Ingenierie-Systeme/united-team-repo/Slides RDV/RDV5.pdf

# United Team

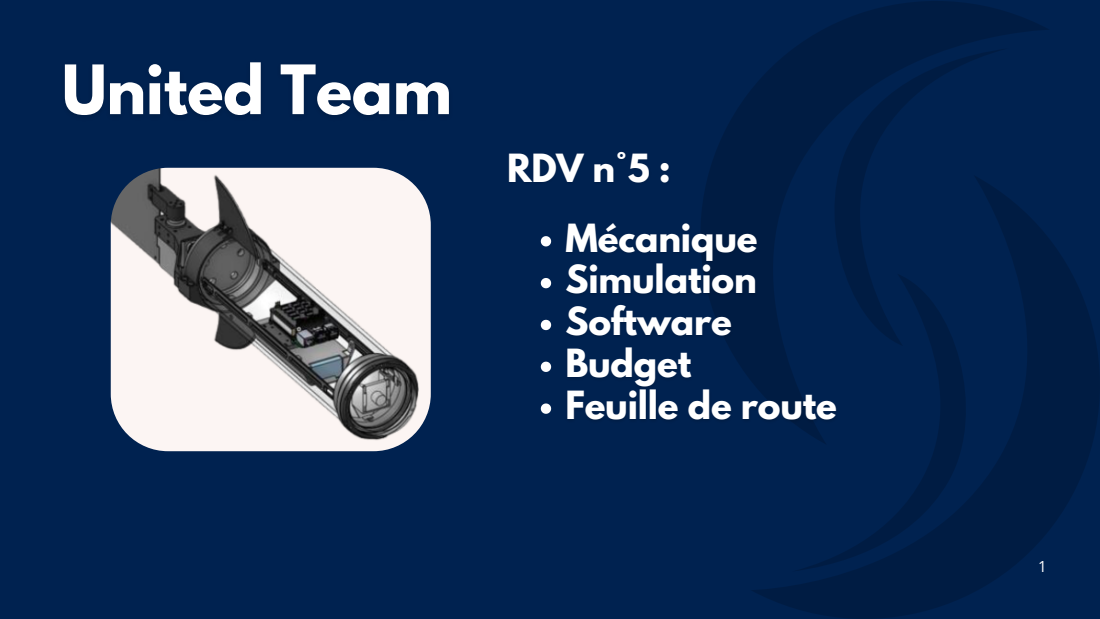
[picture p4: page 1]
RDV n; Mécanique Simulation Software Budget Feuille de route

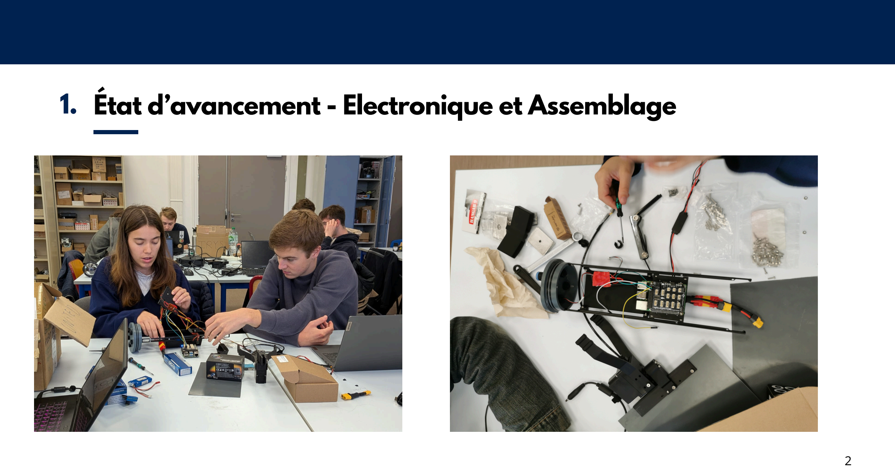
[picture p5: page 2]

### 1. État d’avancement - Electronique et Assemblage

2

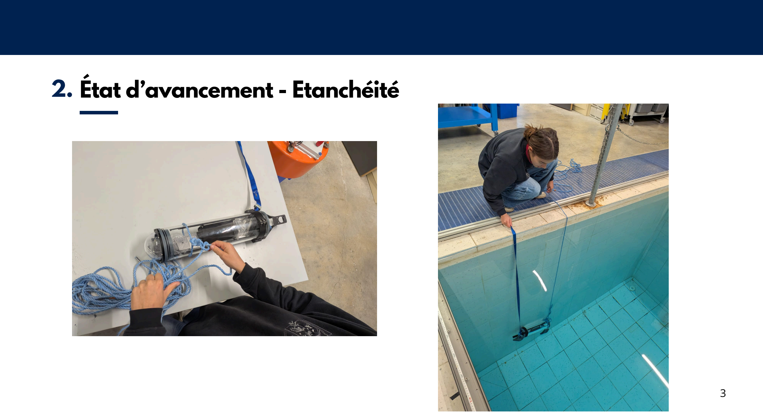
[picture p6: page 3]

### 2. État d’avancement - Etanchéité

3

### 3. État d’avancement - Simulation 3D

4

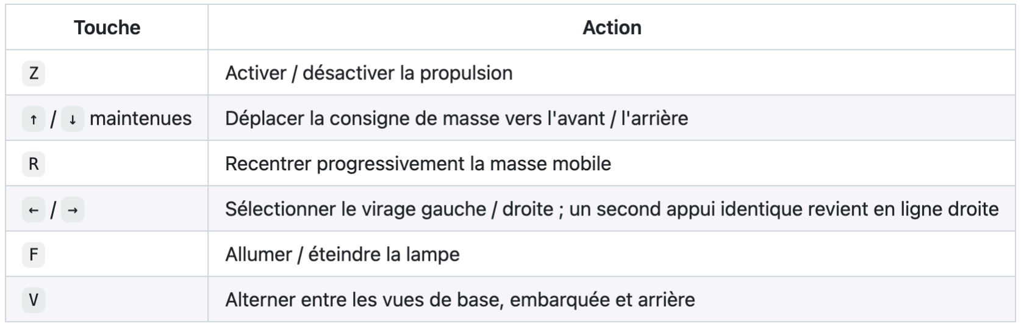
[picture p7: figure]

### 4. État d’avancement - Budget

5

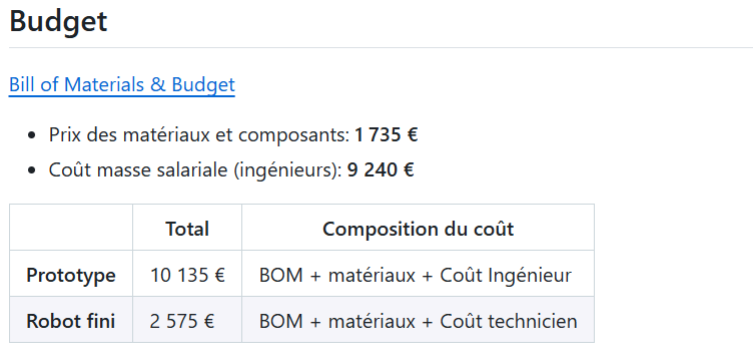
[picture p8: figure]

### 4. État d’avancement - Tests de l’électronique

6

Test servo-moteurs
Test caméra

Test lampe

### 4. État d’avancement - Contrôle et software

7

Fait

En cours

Contrôle manuel clavier pour avancer et tourner

Régulation autonome en
altitude
Stratégie différente pour la rotation

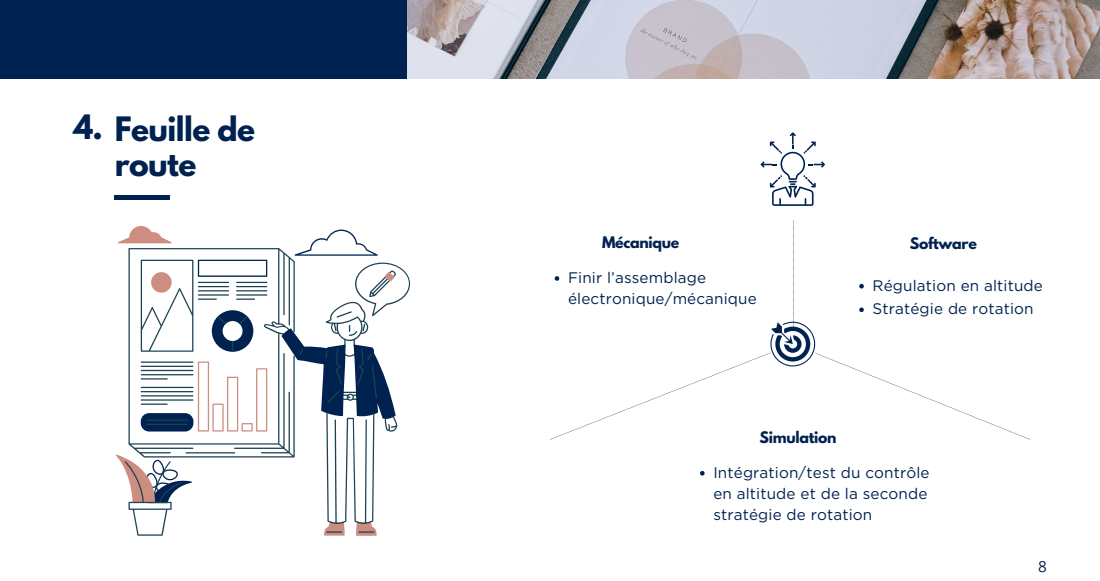
[picture p9: page 8]
4. Feuille de route; Finir l’assemblage électronique/mécanique; Mécanique; Software

Régulation en altitude
Stratégie de rotation

Simulation
Intégration/test du contrôle
en altitude et de la seconde
stratégie de rotation

9

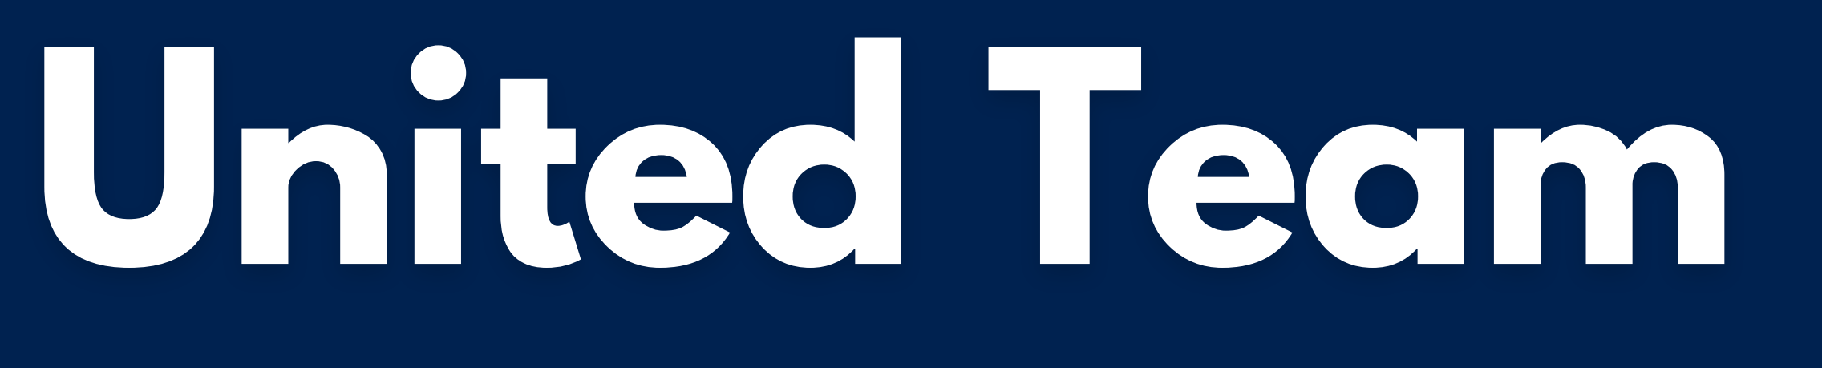
[picture p10: figure]
United Team
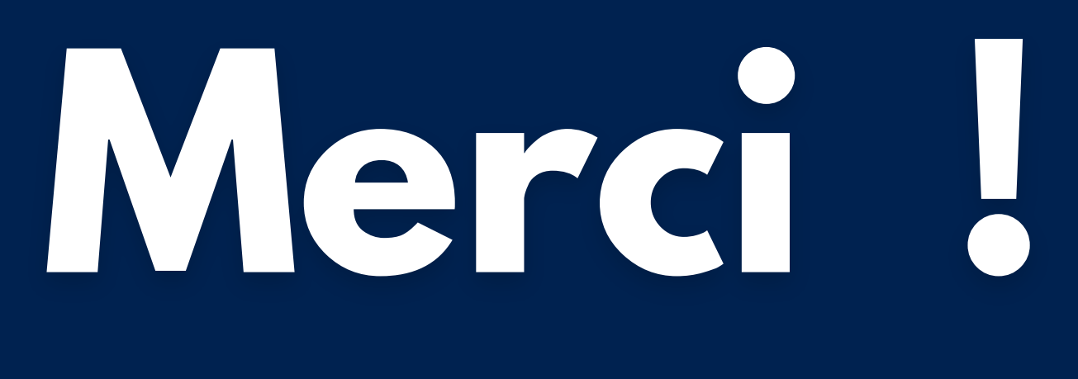
[picture p11: figure]
Merci !
