Ingenierie-Systeme/united-team-repo/Slides RDV/RDV4.pdf

# United Team

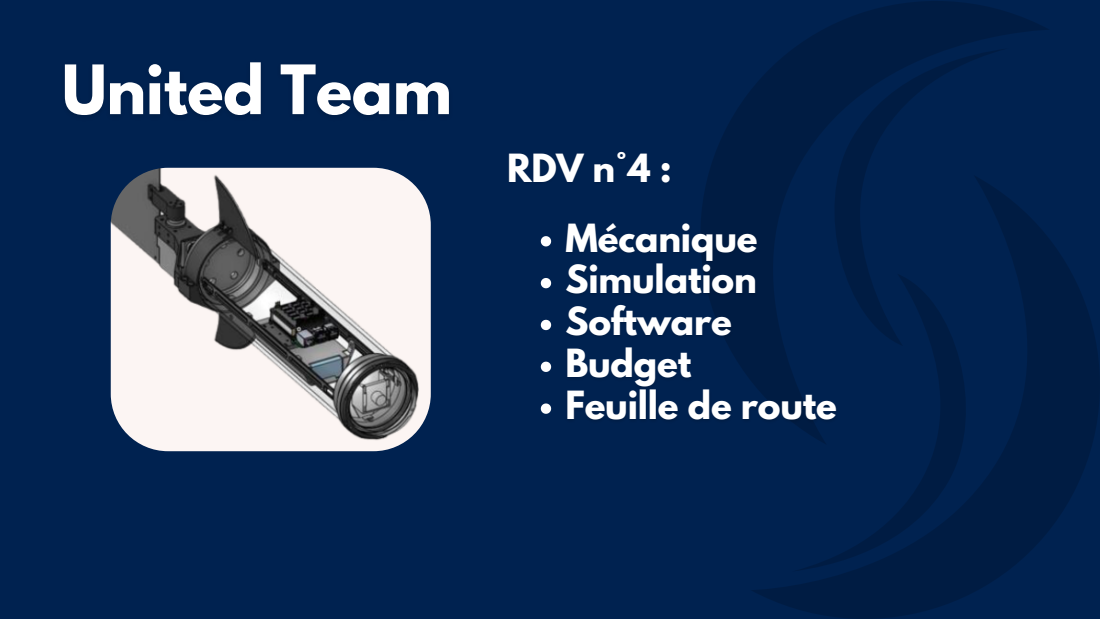
[picture p12: page 1]
RDV n; Mécanique Simulation Software Budget Feuille de route

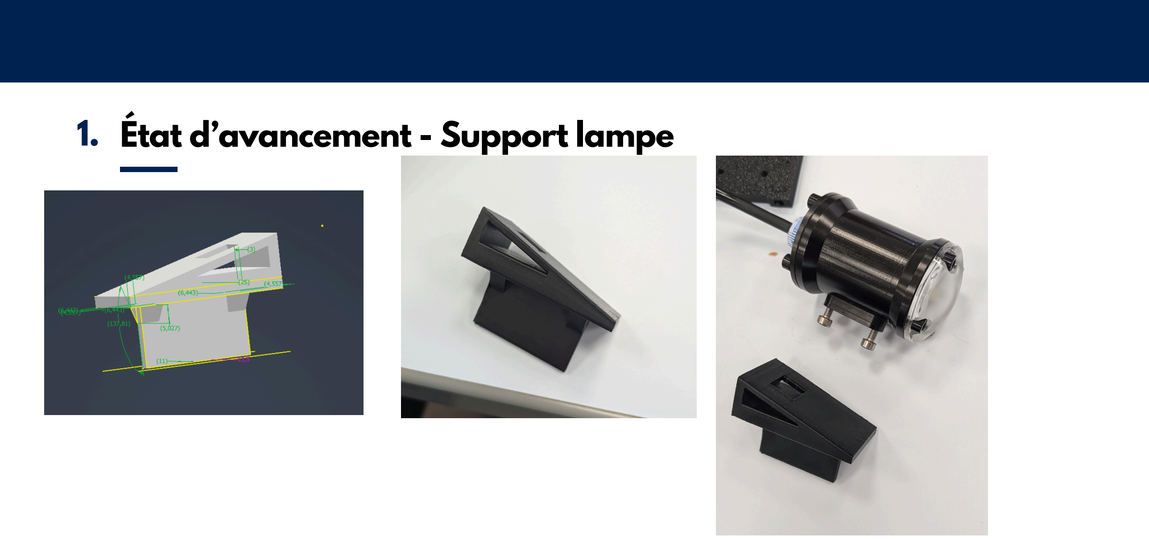
[picture p13: page 2]

### 1. État d’avancement - Support lampe

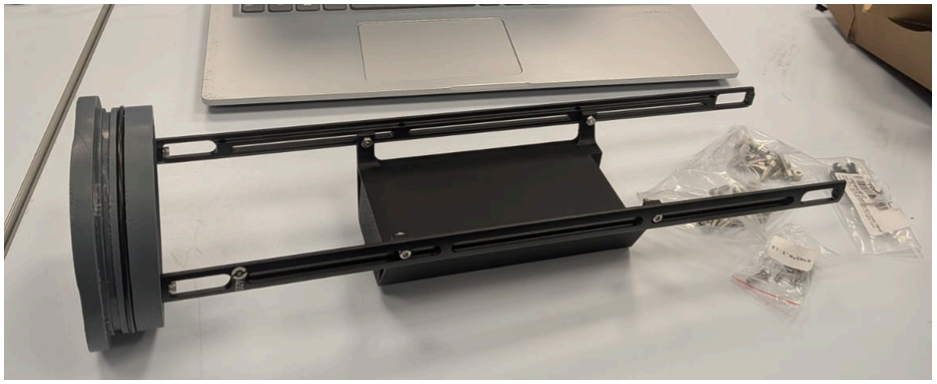
[picture p14: figure]
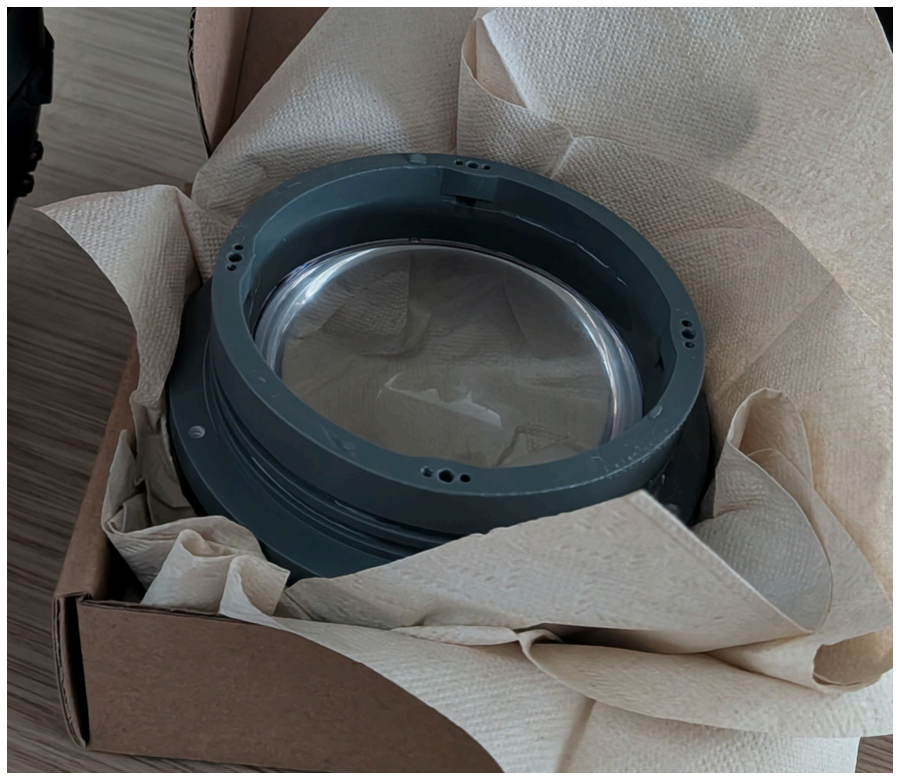
[picture p15: figure]

### 1. État d’avancement - Tube

Taraudage et test d’étanchéité

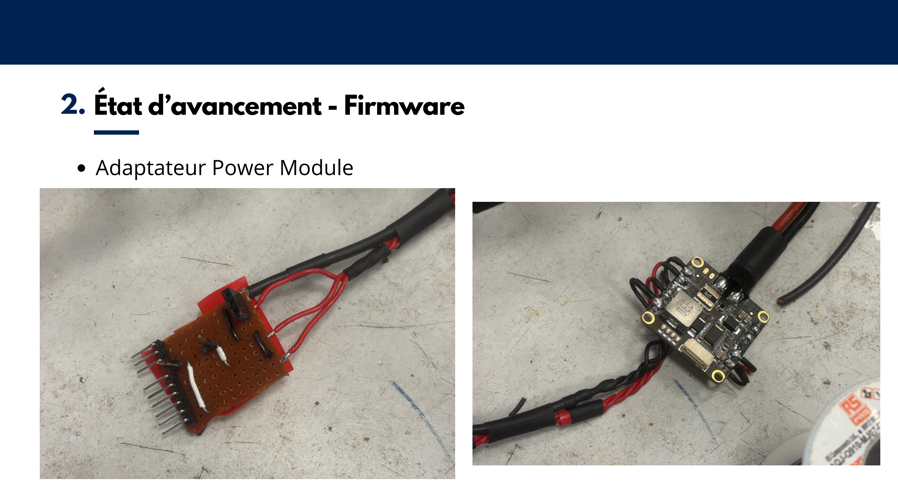
[picture p16: page 4]

### 2. État d’avancement - Firmware

Adaptateur Power Module

### 3. État d’avancement - Simulation

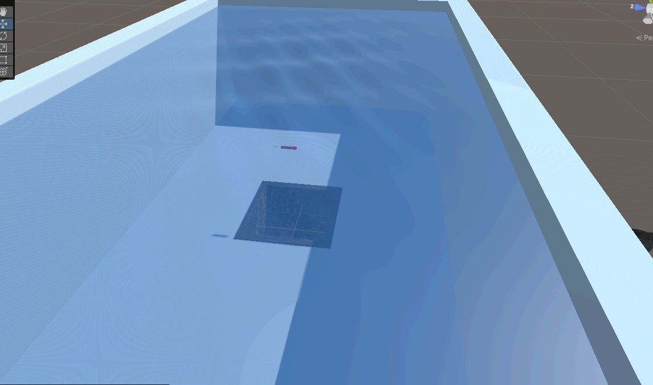
[picture p17: figure]

### 3. État d’avancement - Simulation

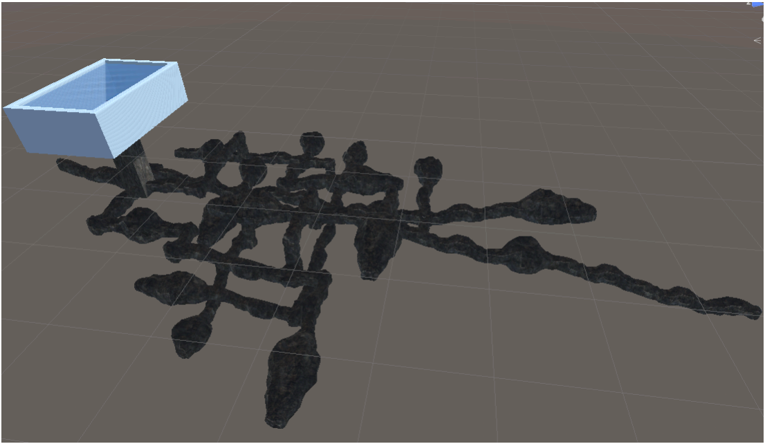
[picture p18: figure]

### 3. État d’avancement - Simulation


### 3. État d’avancement - Software

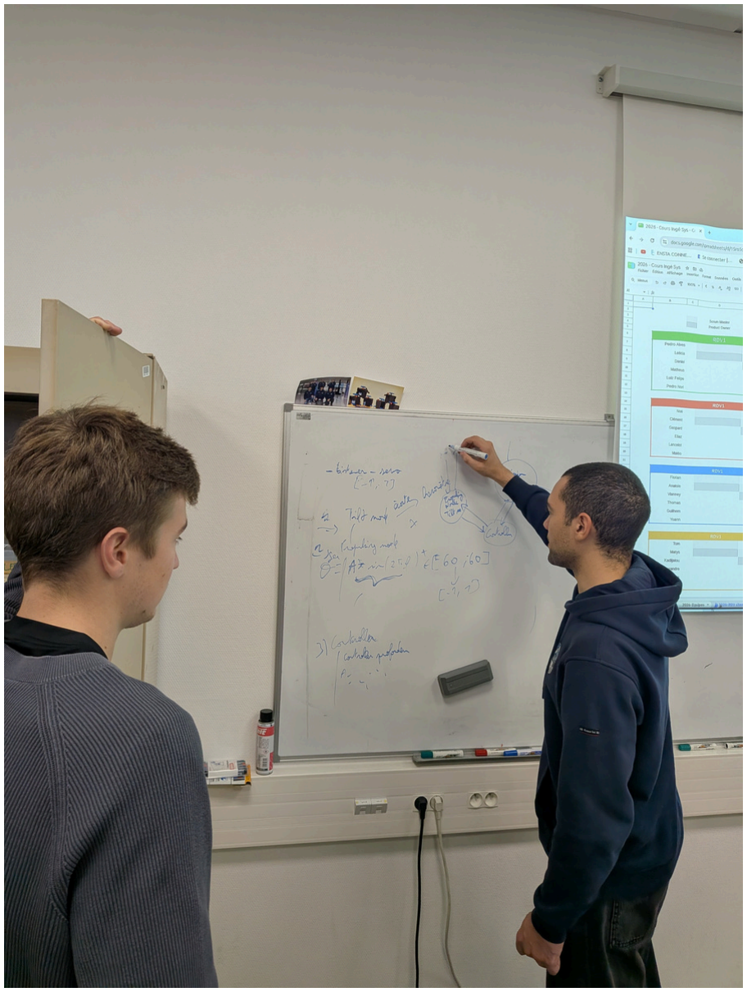
[picture p19: figure]

Fait :
Tester ROS2 avec IMU, lampe, pas encore servo

En cours :
mise en place d’un régulateur en cap et profondeur

### 4. État d’avancement - Budget sur README.md

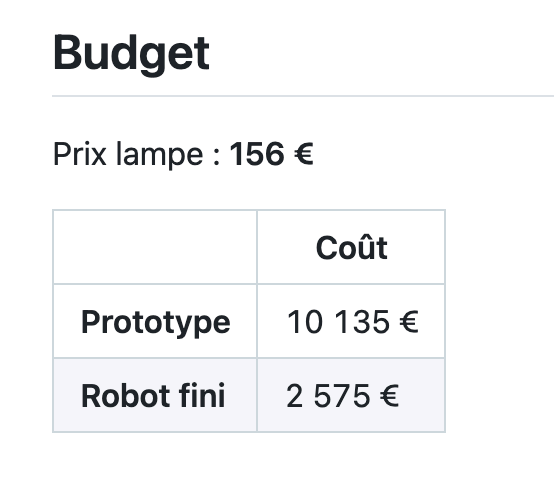
[picture p20: figure]
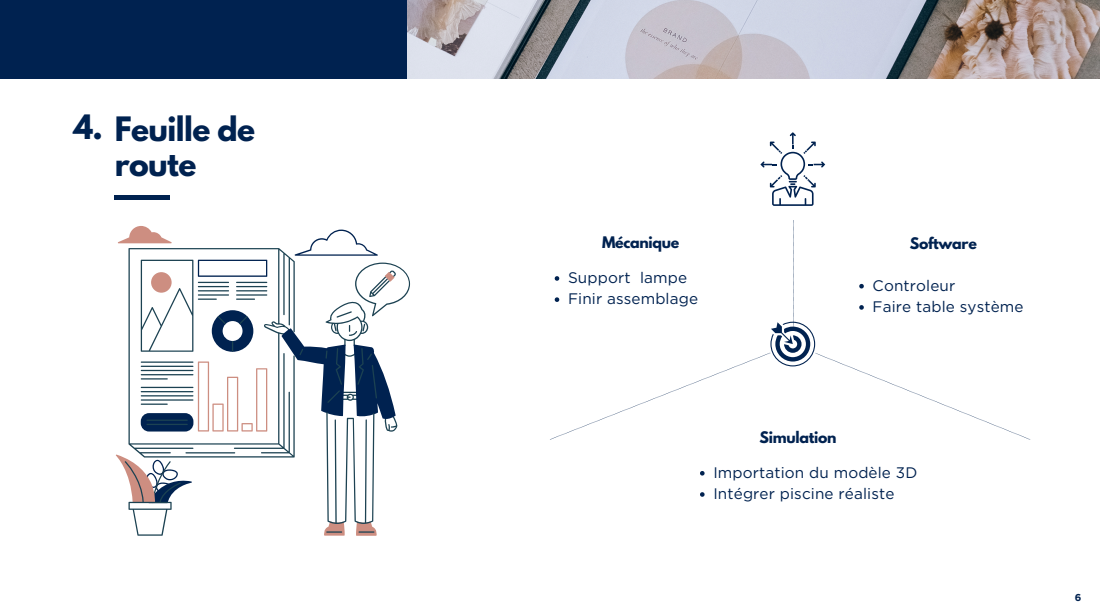
[picture p21: page 10]
4. Feuille de route; Support lampe Finir assemblage; Mécanique; Software

Controleur
Faire table système

Simulation
Importation du modèle 3D
Intégrer piscine réaliste

United Team
Merci !
