Ingenierie-Systeme/united-team-repo/Slides RDV/RDV3.pdf

# United Team

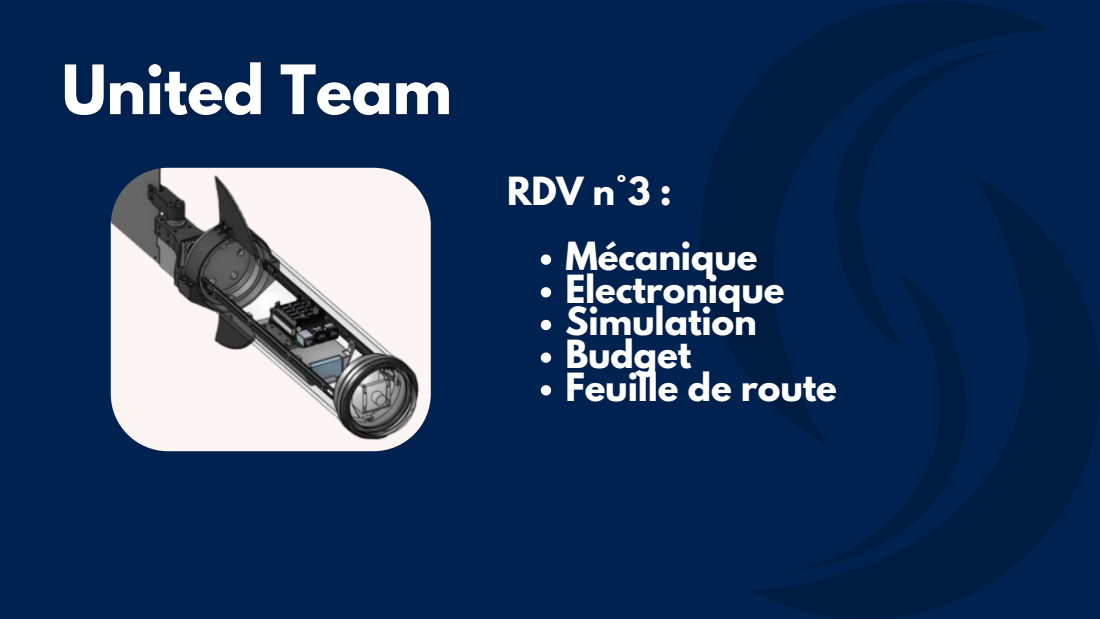
[picture p22: page 1]
RDV n; Mécanique Electronique Simulation Budget Feuille de route

# Montage du moteur étanche 1. État d’avancement - Mécanique

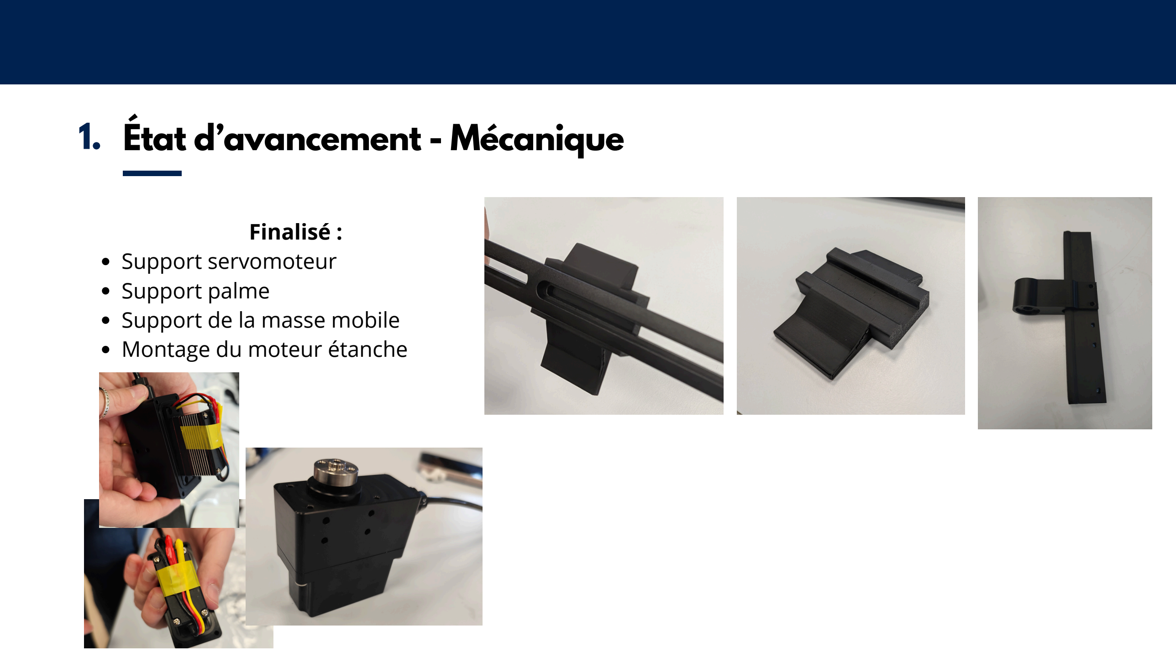
[picture p23: page 2]

# Finalisé :

# Support servomoteur Support palme Support de la masse mobile

# 1. État d’avancement - Mécanique

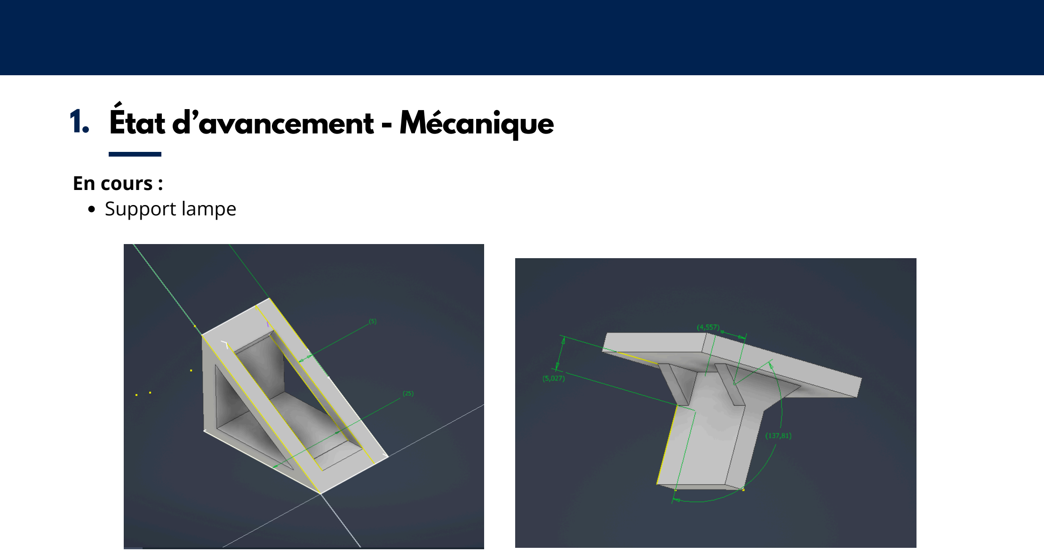
[picture p24: page 3]

# Support lampe

# En cours :

# 2. État d’avancement - Electronique

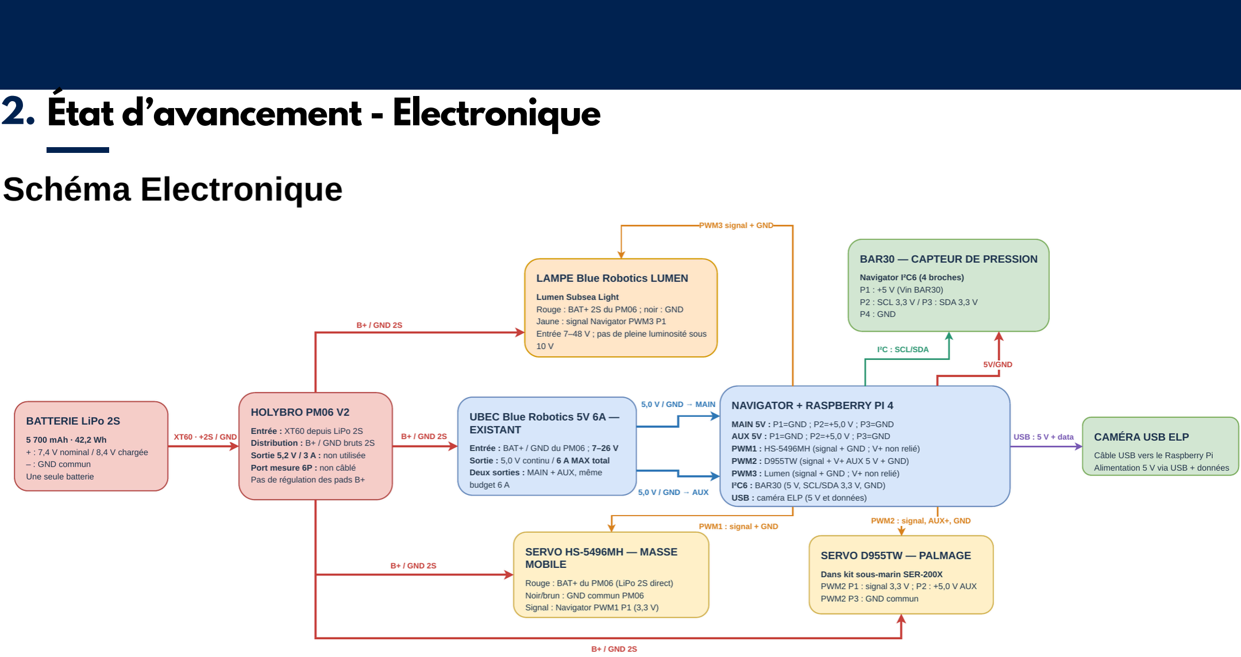
[picture p25: page 4]

# 2. État d’avancement - Firmware

# Setup RaspberryPi packages ROS 2 / packages Python

# 2. État d’avancement - Simulation

# Connexion avec ROS2 Ajout de l’IMU / Capteur de pression

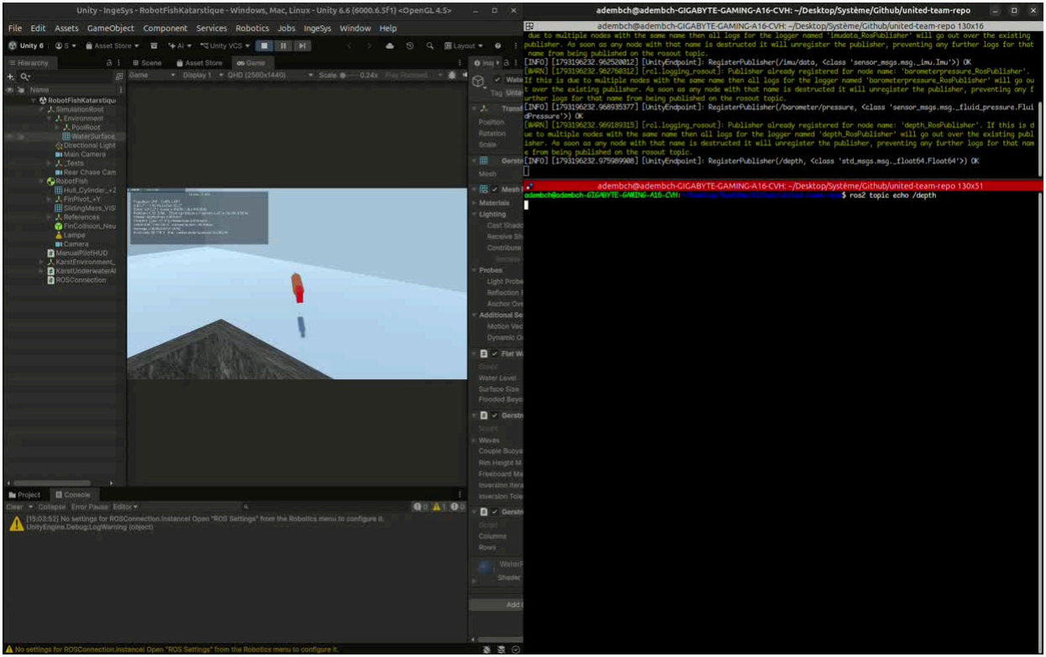
[picture p26: figure]

# 2. État d’avancement - Simulation

# Ajout d’une scène karstique et de la lampe

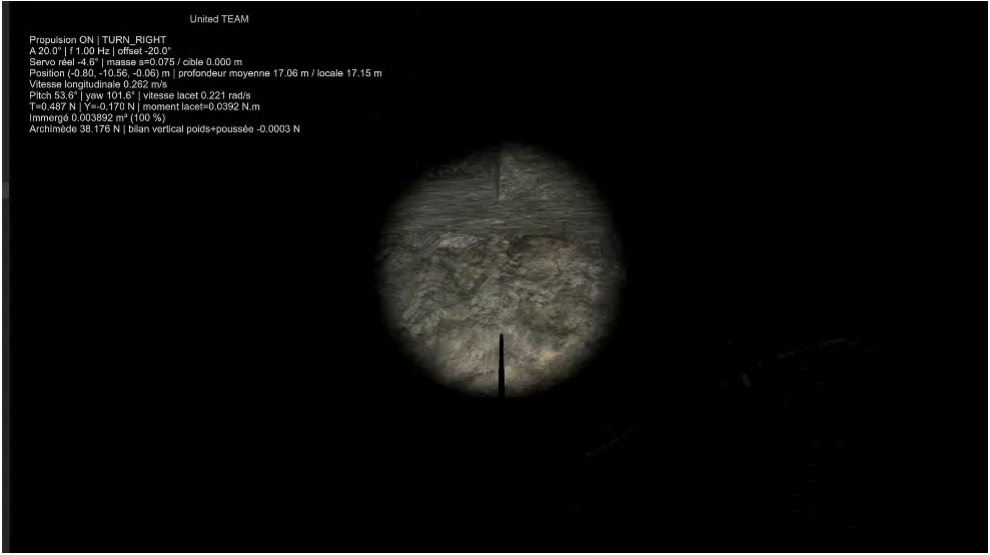
[picture p27: figure]

# 2. État d’avancement - Simulation

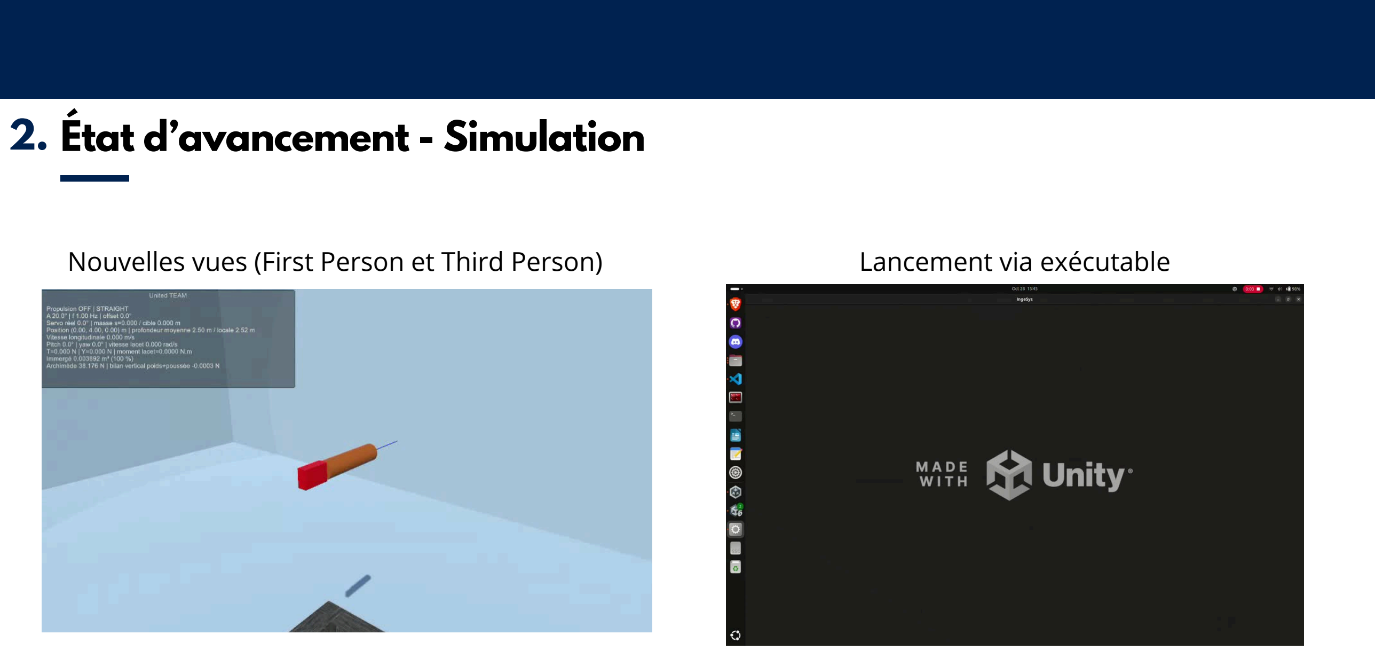
[picture p28: page 8]

Nouvelles vues (First Person et Third Person) | Lancement via exécutable

# 2. État d’avancement - Budget

# Nouveau prix avec la lampe :

10 135 €

+156 €

# Coût prototype : Coût robot fini :

2 575 €

# 4. Feuille de route

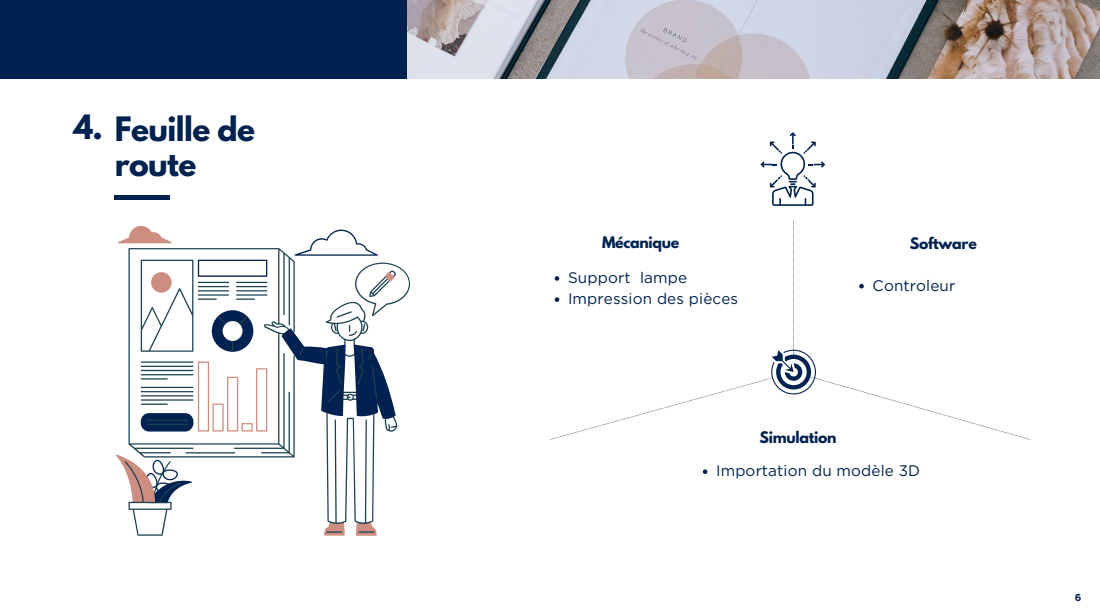
[picture p29: page 10]
Controleur; Software

Mécanique
Support lampe
Impression des pièces

Simulation
Importation du modèle 3D

United Team
Merci !

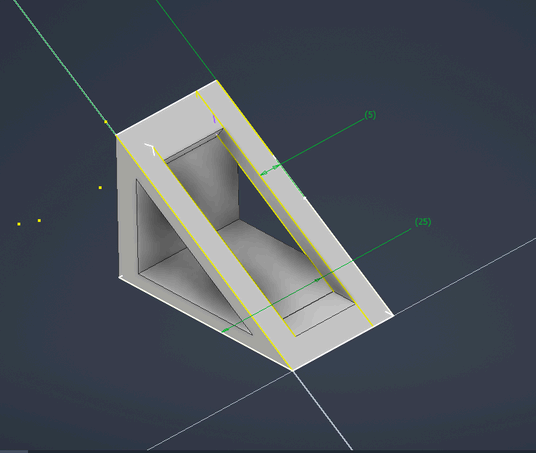
[picture p30: figure]
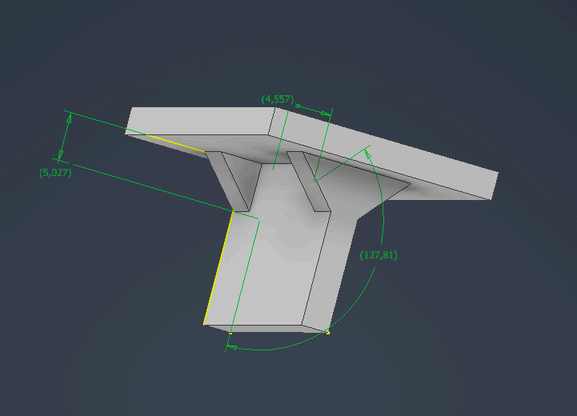
[picture p31: figure]

# 2. État d’avancement - CAO

# Finalisé :

# Support servomoteur masse mobile Support palme Support de la masse mobile

# En cours :

# Support lampe

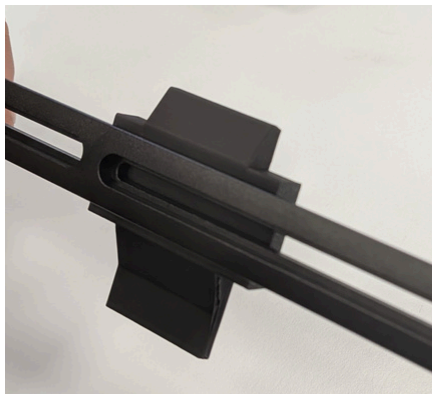
[picture p32: figure]
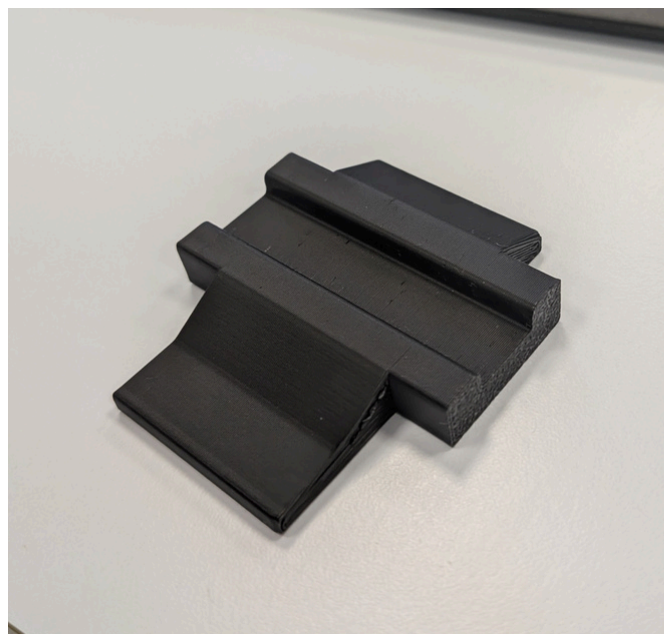
[picture p33: figure]
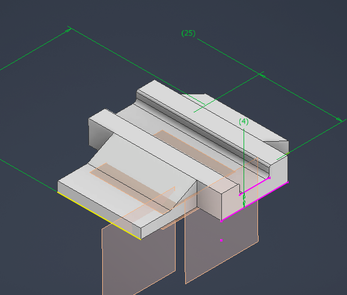
[picture p34: figure]

# 2. État d’avancement - Simulateur & Firmware

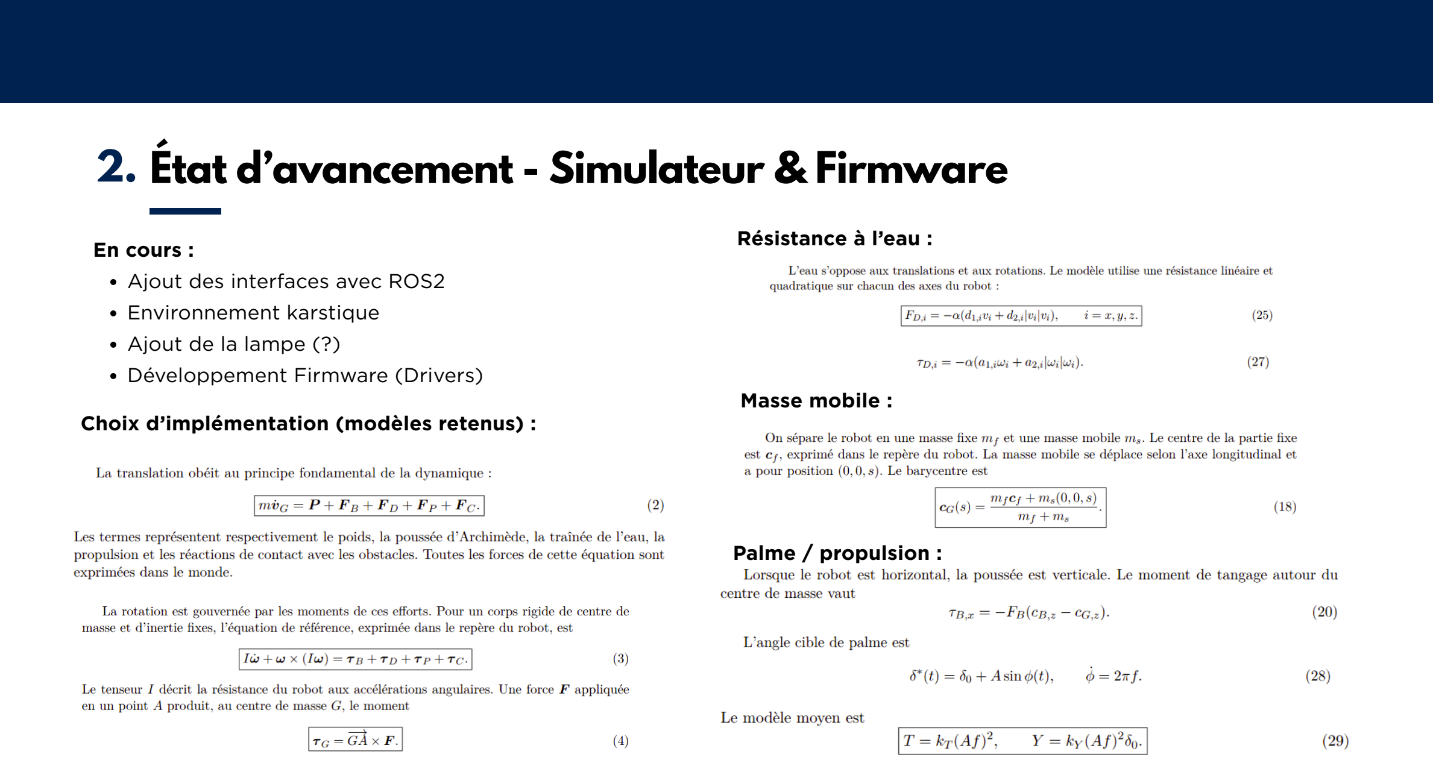
[picture p35: page 13]

# En cours : Ajout des interfaces avec ROS2 Environnement karstique Ajout de la lampe (?) Développement Firmware (Drivers)

# Choix d’implémentation (modèles retenus) :

# Résistance à l’eau :

# Masse mobile :

# Palme / propulsion :

# 2. État d’avancement - Simulateur & Firmware

# Modèle de Houle Trochoïdale (Gerstner) :

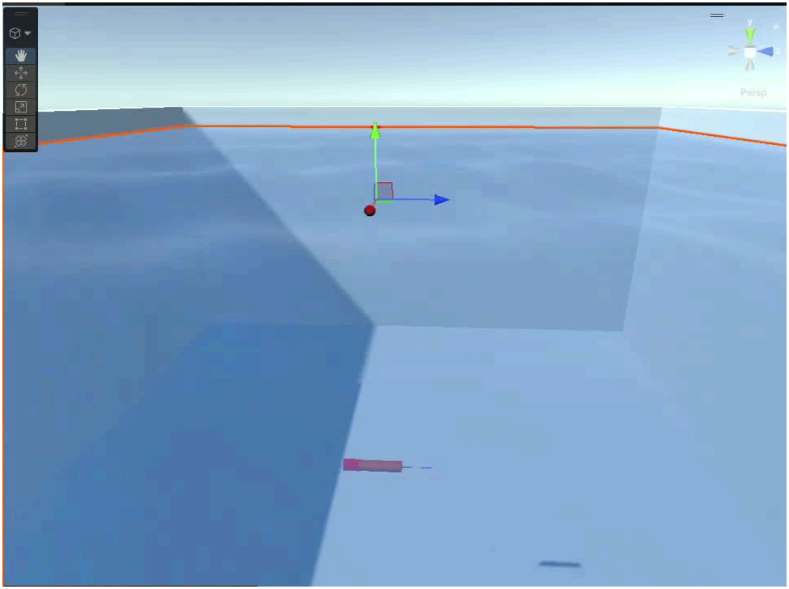
[picture p36: figure]

# Présentation du

1.

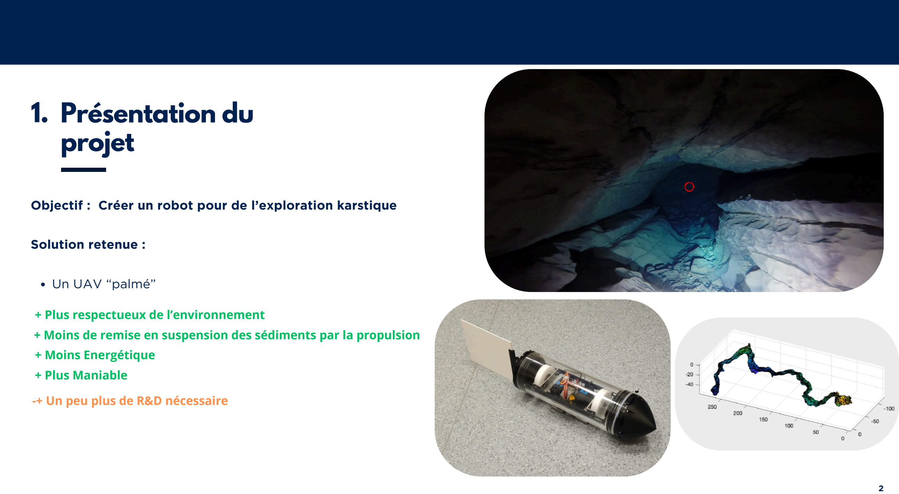
[picture p37: page 15]

# Objectif : Créer un robot pour de l’exploration karstique

# Solution retenue :

# Un UAV “palmé”

# projet

2

# + Plus respectueux de l’environnement

# + Moins Energétique

# -+ Un peu plus de R&D nécessaire

# + Moins de remise en suspension des sédiments par la propulsion

# + Plus Maniable

# 3. Etat d’avancement

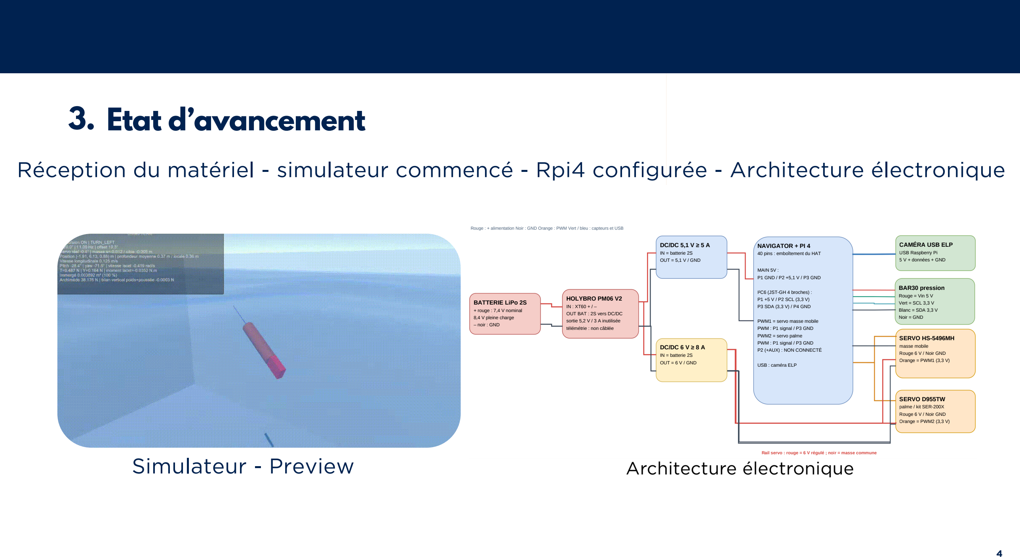
[picture p38: page 16]

4

# Réception du matériel - simulateur commencé - Rpi4 configurée - Architecture électronique

# Simulateur - Preview

Rouge : + alimentation Noir : GND Orange : PWM Vert / bleu : capteurs et USB

Rail servo : rouge = 6 V régulé ; noir = masse commune

### BATTERIE LiPo 2S

+ rouge : 7,4 V nominal
8,4 V pleine charge
– noir : GND

### HOLYBRO PM06 V2

IN : XT60 + / –
OUT BAT : 2S vers DC/DC
sortie 5,2 V / 3 A inutilisée télémétrie : non câblée

### DC/DC 6 V ≥ 8 A

IN = batterie 2S
OUT = 6 V / GND

### DC/DC 5,1 V ≥ 5 A

IN = batterie 2S
OUT = 5,1 V / GND

### NAVIGATOR + PI 4

40 pins : emboîtement du HAT

### SERVO D955TW

palme / kit SER-200X
Rouge 6 V / Noir GND
Orange = PWM2 (3,3 V)

### BAR30 pression

Rouge = Vin 5 V
Vert = SCL 3,3 V
Blanc = SDA 3,3 V
Noir = GND

### CAMÉRA USB ELP

USB Raspberry Pi
5 V + données + GND

### SERVO HS-5496MH

masse mobile
Rouge 6 V / Noir GND
Orange = PWM1 (3,3 V)
USB : caméra ELP

I²C6 (JST-GH 4 broches) :
P1 +5 V / P2 SCL (3,3 V)
P3 SDA (3,3 V) / P4 GND

MAIN 5V :
P1 GND / P2 +5,1 V / P3 GND

PWM1 = servo masse mobile
PWM : P1 signal / P3 GND
PWM2 = servo palme
PWM : P1 signal / P3 GND
P2 (+AUX) : NON CONNECTÉ

# Architecture électronique

# Rouge : + alimentation Noir : GND Orange : PWM Vert / bleu : capteurs et USB

# DC/DC 5,1 V ≥ 5 A

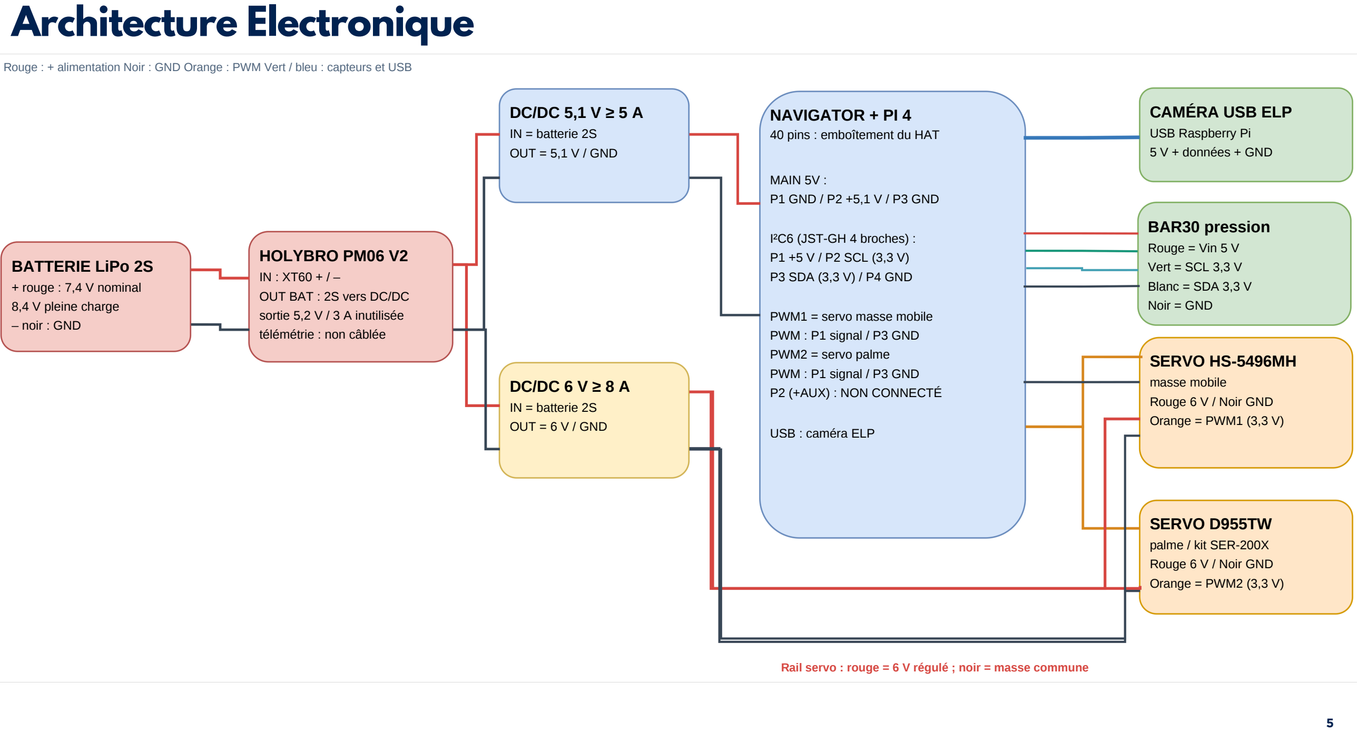
[picture p39: page 17]

# Rail servo : rouge = 6 V régulé ; noir = masse commune

# BATTERIE LiPo 2S

# + rouge : 7,4 V nominal 8,4 V pleine charge – noir : GND

# HOLYBRO PM06 V2

# IN : XT60 + / – OUT BAT : 2S vers DC/DC sortie 5,2 V / 3 A inutilisée télémétrie : non câblée

# DC/DC 6 V ≥ 8 A

# IN = batterie 2S OUT = 6 V / GND

# IN = batterie 2S OUT = 5,1 V / GND

# NAVIGATOR + PI 4

# 40 pins : emboîtement du HAT

# SERVO D955TW

# palme / kit SER-200X Rouge 6 V / Noir GND Orange = PWM2 (3,3 V)

# BAR30 pression

# Rouge = Vin 5 V Vert = SCL 3,3 V Blanc = SDA 3,3 V Noir = GND

# CAMÉRA USB ELP

# USB Raspberry Pi 5 V + données + GND

# SERVO HS-5496MH

# masse mobile Rouge 6 V / Noir GND Orange = PWM1 (3,3 V) USB : caméra ELP

# I²C6 (JST-GH 4 broches) : P1 +5 V / P2 SCL (3,3 V) P3 SDA (3,3 V) / P4 GND

# MAIN 5V : P1 GND / P2 +5,1 V / P3 GND

# PWM1 = servo masse mobile PWM : P1 signal / P3 GND PWM2 = servo palme PWM : P1 signal / P3 GND P2 (+AUX) : NON CONNECTÉ

# Architecture Electronique

5
