Ingenierie-Systeme/united-team-repo/Slides RDV/RDV1.pdf

# United Team

# RDV n

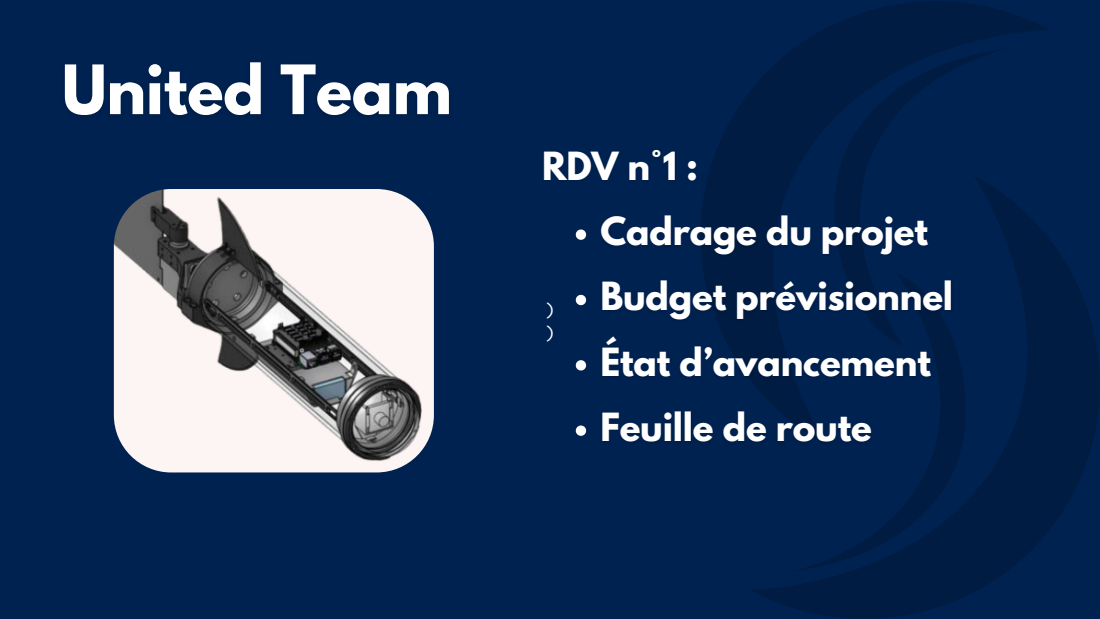
[picture p40: page 1]
Cadrage du projet; Budget prévisionnel État d’avancement; Feuille de route

RDV n
Cadrage du projet
Budget prévisionnel
État d’avancement
Feuille de route

# Présentation du

1.


# Objectif : Créer un robot pour de l’exploration karstique

# Solution retenue :

# Un UAV “palmé”

# projet

2

# + Plus respectueux de l’environnement

# + Moins Energétique

# -+ Un peu plus de R&D nécessaire

# + Moins de remise en suspension des sédiments par la propulsion

# + Plus Maniable

# Budget Prévisionnel

2.

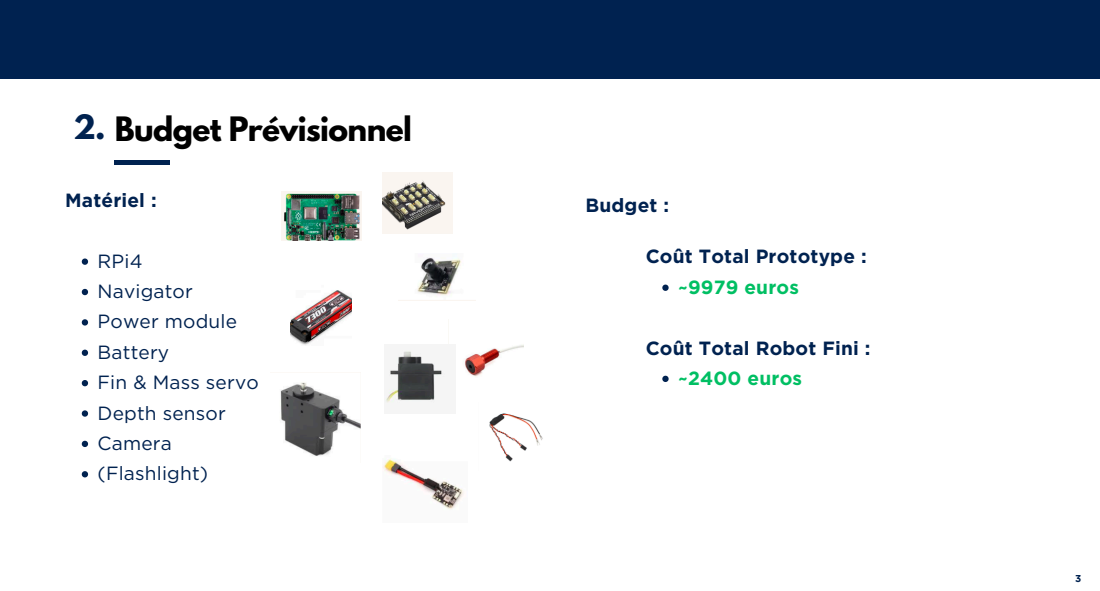
[picture p41: page 3]
Matériel :; RPi4 Navigator Power module Battery Fin & Mass servo Depth sensor Camera (Flashlight); Budget :

Coût Total Prototype :
~9979 euros

Coût Total Robot Fini :
~2400 euros

# 3. Etat d’avancement


4

# Réception du matériel - simulateur commencé - Rpi4 configurée - Architecture électronique

# Simulateur - Preview

Rouge : + alimentation Noir : GND Orange : PWM Vert / bleu : capteurs et USB

Rail servo : rouge = 6 V régulé ; noir = masse commune

### BATTERIE LiPo 2S

+ rouge : 7,4 V nominal
8,4 V pleine charge
– noir : GND

### HOLYBRO PM06 V2

IN : XT60 + / –
OUT BAT : 2S vers DC/DC
sortie 5,2 V / 3 A inutilisée télémétrie : non câblée

### DC/DC 6 V ≥ 8 A

IN = batterie 2S
OUT = 6 V / GND

### DC/DC 5,1 V ≥ 5 A

IN = batterie 2S
OUT = 5,1 V / GND

### NAVIGATOR + PI 4

40 pins : emboîtement du HAT

### SERVO D955TW

palme / kit SER-200X
Rouge 6 V / Noir GND
Orange = PWM2 (3,3 V)

### BAR30 pression

Rouge = Vin 5 V
Vert = SCL 3,3 V
Blanc = SDA 3,3 V
Noir = GND

### CAMÉRA USB ELP

USB Raspberry Pi
5 V + données + GND

### SERVO HS-5496MH

masse mobile
Rouge 6 V / Noir GND
Orange = PWM1 (3,3 V)
USB : caméra ELP

I²C6 (JST-GH 4 broches) :
P1 +5 V / P2 SCL (3,3 V)
P3 SDA (3,3 V) / P4 GND

MAIN 5V :
P1 GND / P2 +5,1 V / P3 GND

PWM1 = servo masse mobile
PWM : P1 signal / P3 GND
PWM2 = servo palme
PWM : P1 signal / P3 GND
P2 (+AUX) : NON CONNECTÉ

# Architecture électronique

# Rouge : + alimentation Noir : GND Orange : PWM Vert / bleu : capteurs et USB

# DC/DC 5,1 V ≥ 5 A


# Rail servo : rouge = 6 V régulé ; noir = masse commune

# BATTERIE LiPo 2S

# + rouge : 7,4 V nominal 8,4 V pleine charge – noir : GND

# HOLYBRO PM06 V2

# IN : XT60 + / – OUT BAT : 2S vers DC/DC sortie 5,2 V / 3 A inutilisée télémétrie : non câblée

# DC/DC 6 V ≥ 8 A

# IN = batterie 2S OUT = 6 V / GND

# IN = batterie 2S OUT = 5,1 V / GND

# NAVIGATOR + PI 4

# 40 pins : emboîtement du HAT

# SERVO D955TW

# palme / kit SER-200X Rouge 6 V / Noir GND Orange = PWM2 (3,3 V)

# BAR30 pression

# Rouge = Vin 5 V Vert = SCL 3,3 V Blanc = SDA 3,3 V Noir = GND

# CAMÉRA USB ELP

# USB Raspberry Pi 5 V + données + GND

# SERVO HS-5496MH

# masse mobile Rouge 6 V / Noir GND Orange = PWM1 (3,3 V) USB : caméra ELP

# I²C6 (JST-GH 4 broches) : P1 +5 V / P2 SCL (3,3 V) P3 SDA (3,3 V) / P4 GND

# MAIN 5V : P1 GND / P2 +5,1 V / P3 GND

# PWM1 = servo masse mobile PWM : P1 signal / P3 GND PWM2 = servo palme PWM : P1 signal / P3 GND P2 (+AUX) : NON CONNECTÉ

# Architecture Electronique

5

# 4. Feuille de route

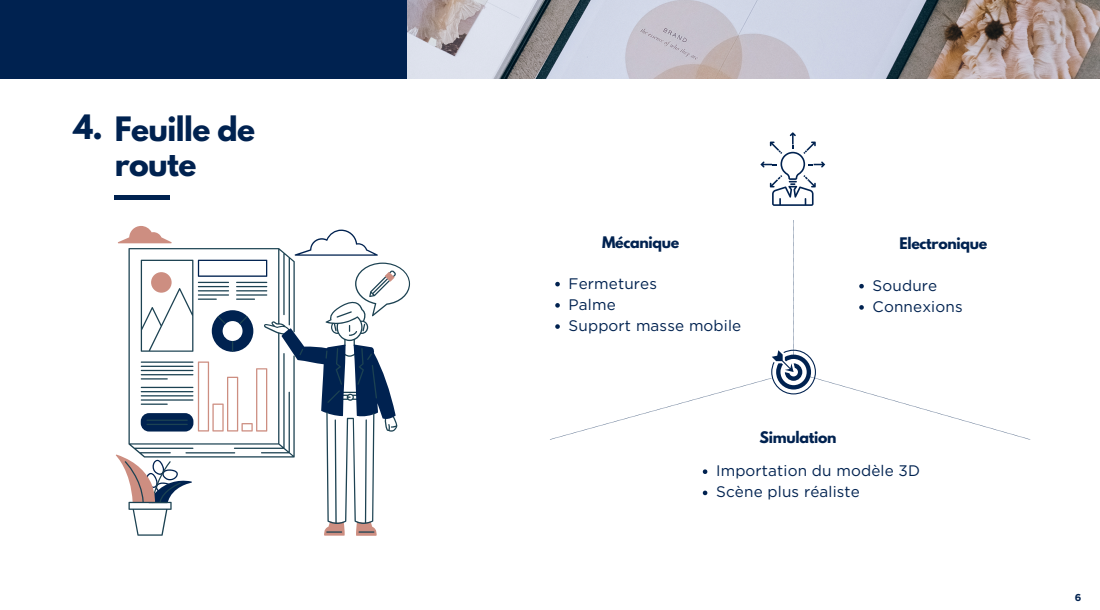
[picture p42: page 6]
Soudure Connexions; Mécanique; Electronique

Fermetures
Palme
Support masse mobile

Simulation
Importation du modèle 3D
Scène plus réaliste

United Team
Merci !
