Ingenierie-Systeme/united-team-repo/Slides RDV/RDV2.pdf

# United Team

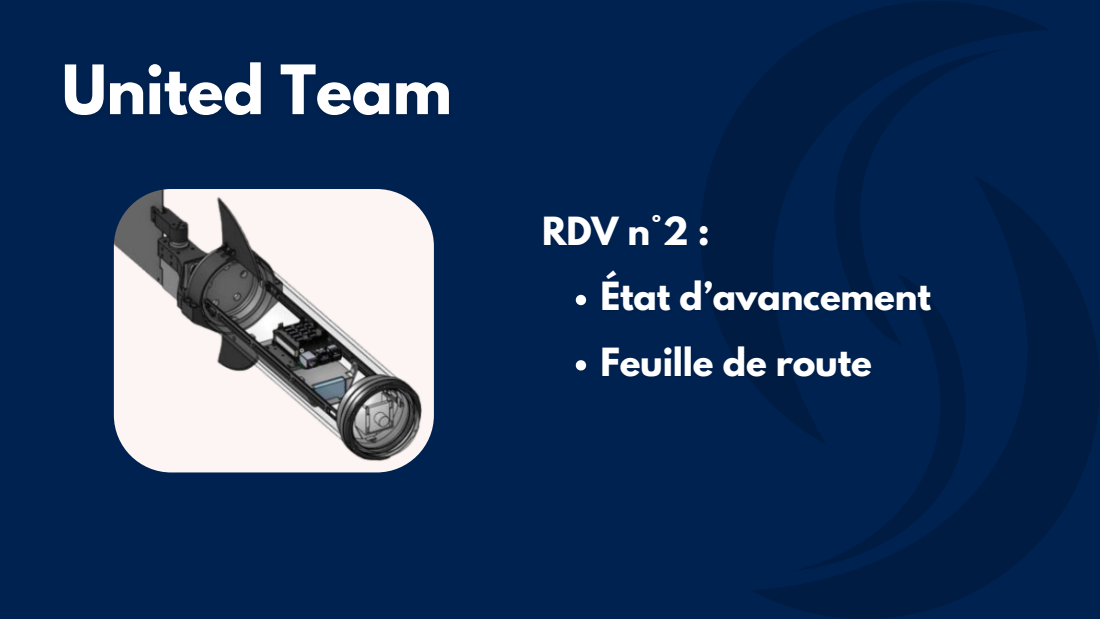
[picture p43: page 1]
RDV n

RDV n
État d’avancement
Feuille de route

# 2. État d’avancement - CAO

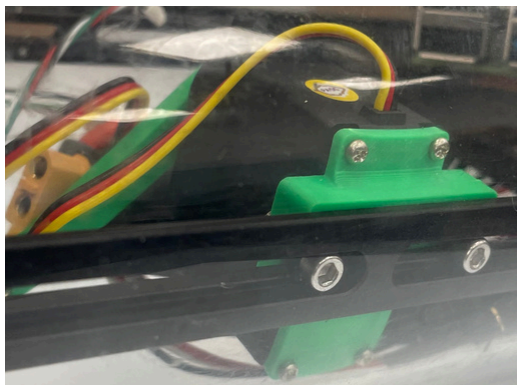
[picture p44: figure]
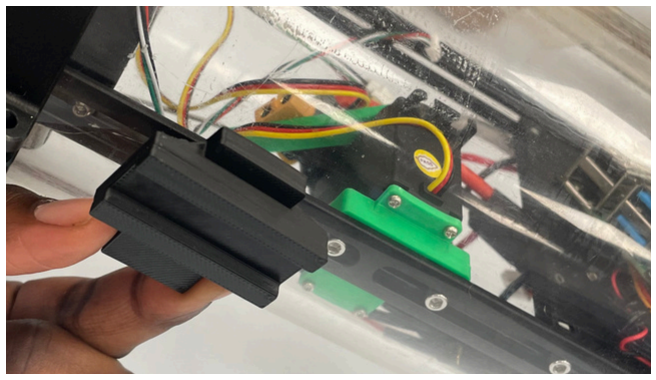
[picture p45: figure]

## En Cours :

## Support servomoteur Support palme Support de la masse mobile Complétion de la structure du robot

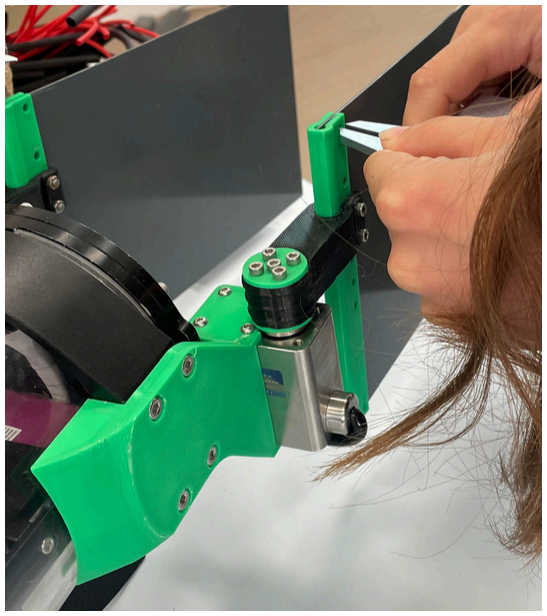
[picture p46: figure]

# 2. État d’avancement - Simulateur & Firmware


En cours :
Ajout des interfaces avec ROS2 Environnement karstique
Ajout de la lampe (?)
Développement Firmware (Drivers)

Choix d’implémentation (modèles retenus) :

Résistance à l’eau :

Masse mobile :

Palme / propulsion :

# 2. État d’avancement - Simulateur & Firmware

Modèle de Houle Trochoïdale (Gerstner) :


# 4. Feuille de route

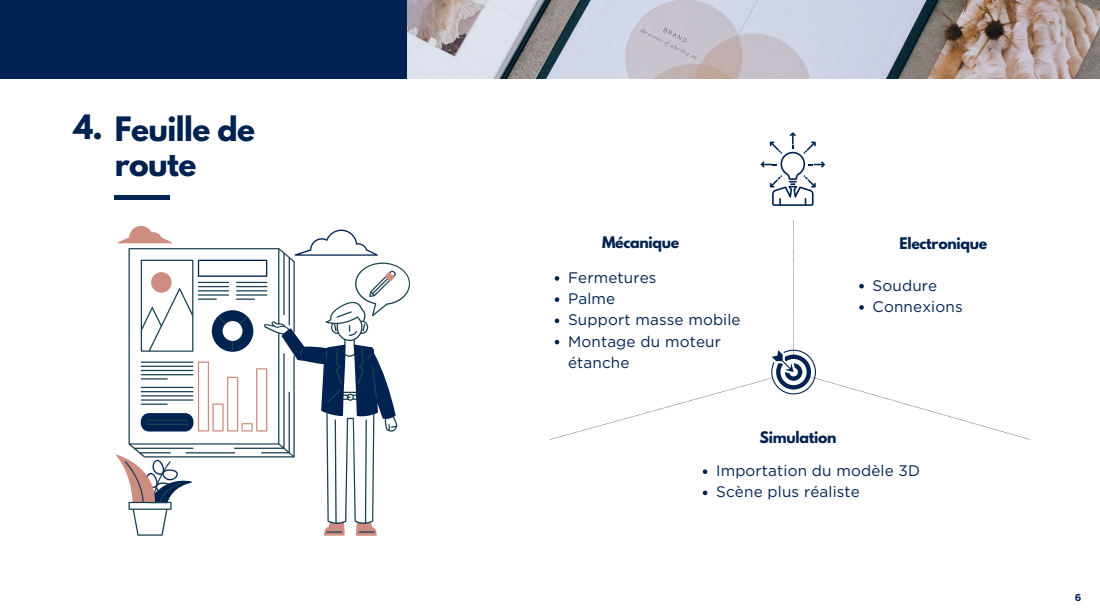
[picture p47: page 5]
Soudure Connexions; Electronique

Mécanique
Fermetures
Palme
Support masse mobile
Montage du moteur
étanche

Simulation
Importation du modèle 3D
Scène plus réaliste

United Team
Merci !
