Ingenierie-Systeme/united-team-repo/Simulateur Unity/IngeSys/IngeSys/Assets/CAD/BestPiscine/Derived/asphalt_04_MetallicSmoothness.png

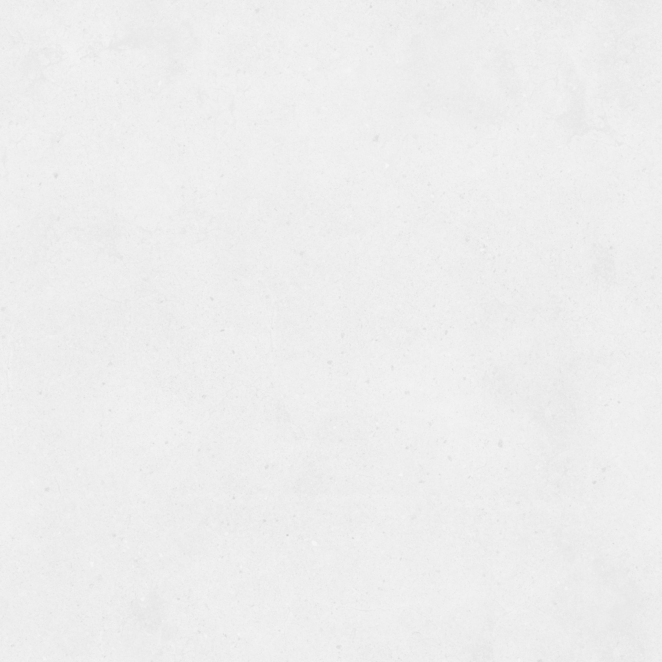
Simulateur Unity/IngeSys/IngeSys/Assets/CAD/BestPiscine/Derived/asphalt_04_MetallicSmoothness.png
