Ingenierie-Systeme/united-team-repo/Simulateur Unity/IngeSys/IngeSys/Assets/CAD/BestPiscine/Derived/beige_wall_001_MetallicSmoothness.png

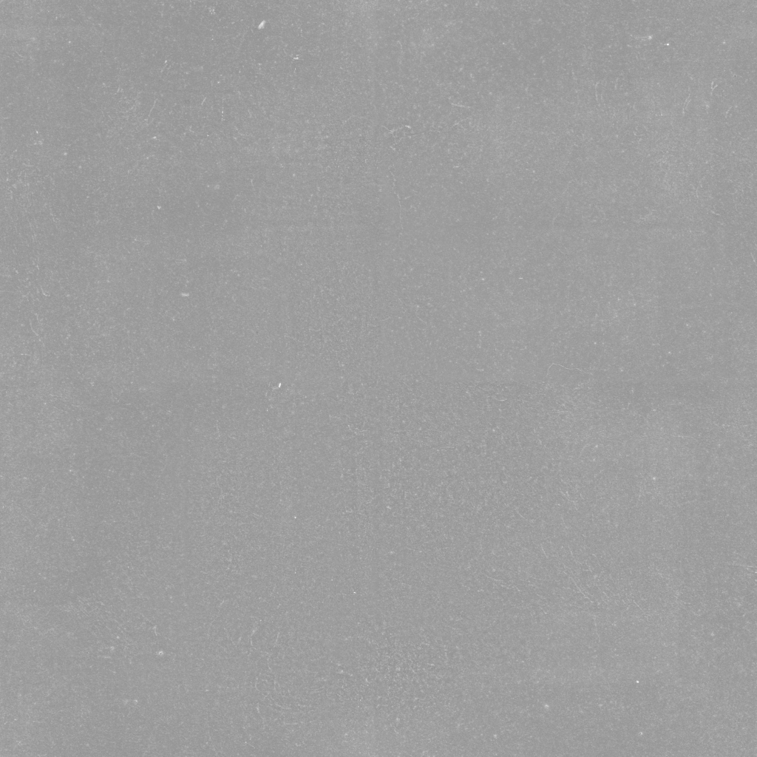
Simulateur Unity/IngeSys/IngeSys/Assets/CAD/BestPiscine/Derived/beige_wall_001_MetallicSmoothness.png
