Ingenierie-Systeme/united-team-repo/Simulateur Unity/IngeSys/IngeSys/Assets/CAD/BestPiscine/Derived/concrete_floor_worn_001_MetallicSmoothness.png

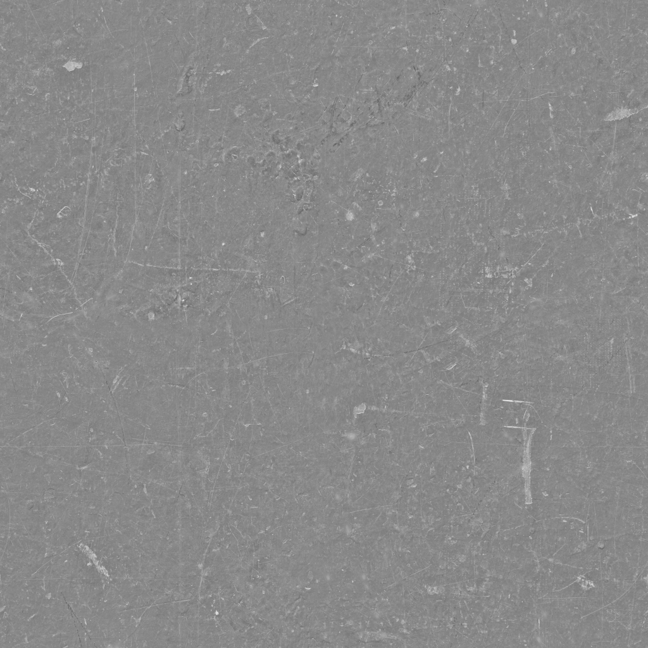
Simulateur Unity/IngeSys/IngeSys/Assets/CAD/BestPiscine/Derived/concrete_floor_worn_001_MetallicSmoothness.png
