Ingenierie-Systeme/united-team-repo/Simulateur Unity/IngeSys/IngeSys/Assets/CAD/BestPiscine/Derived/oak_veneer_01_MetallicSmoothness.png

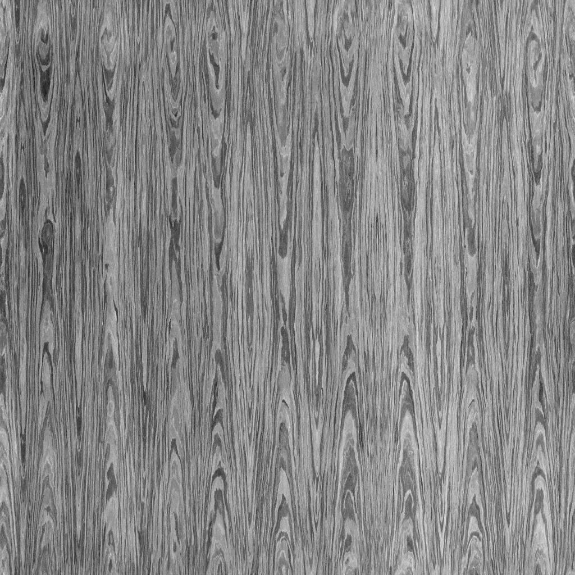
Simulateur Unity/IngeSys/IngeSys/Assets/CAD/BestPiscine/Derived/oak_veneer_01_MetallicSmoothness.png
