Ingenierie-Systeme/united-team-repo/Simulateur Unity/IngeSys/IngeSys/Assets/CAD/BestPiscine/Derived/terlenka_MetallicSmoothness.png

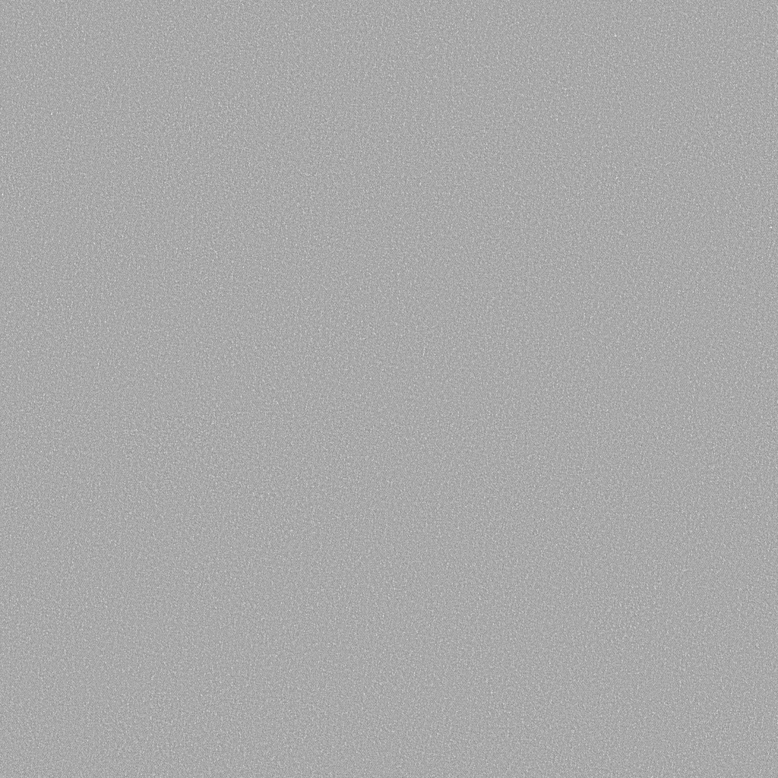
Simulateur Unity/IngeSys/IngeSys/Assets/CAD/BestPiscine/Derived/terlenka_MetallicSmoothness.png
