Ingenierie-Systeme/united-team-repo/Slides RDV/Capture d'écran 2026-11-04 103200.png

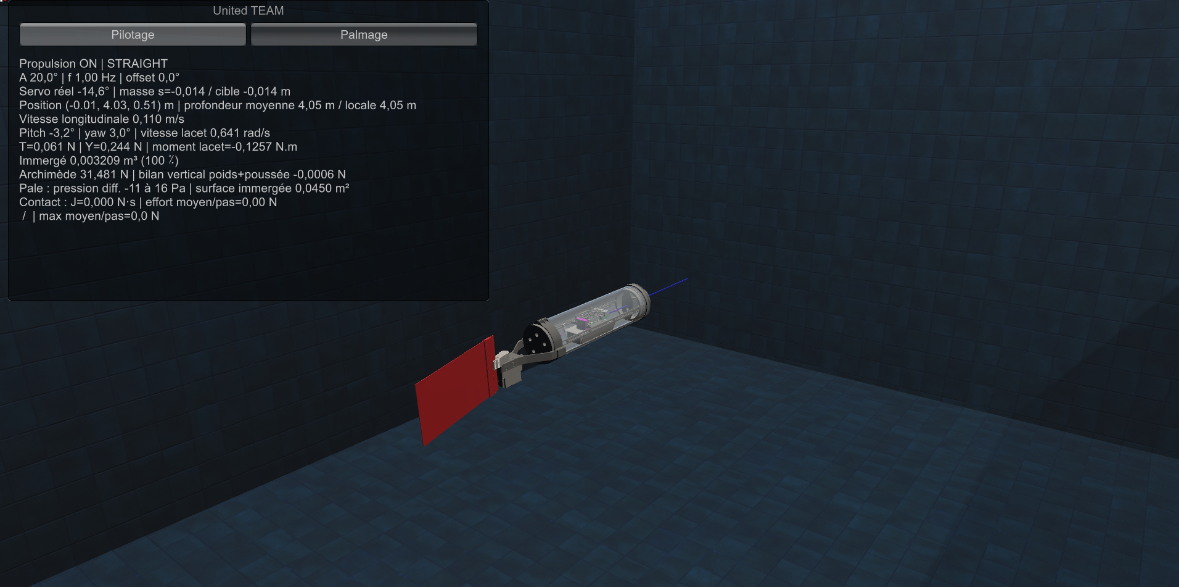
Slides RDV/Capture d'écran 2026-11-04 103200.png
