Ingenierie-Systeme/united-team-repo/CAO/support_masse_sys_inge.stl

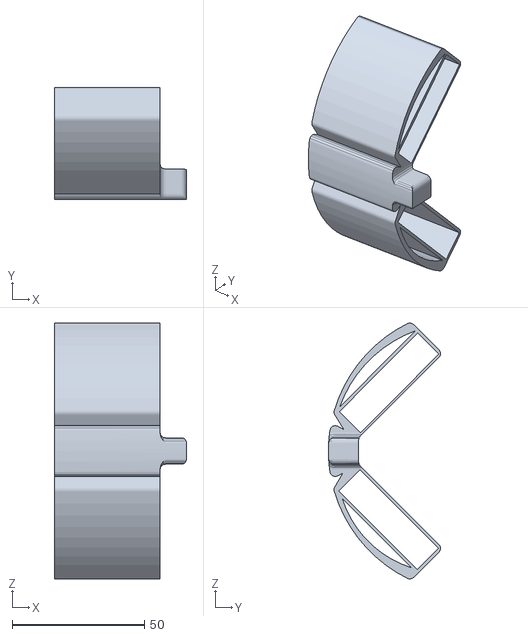
[picture p54: CAD file, 2026-11-04]
CAO/support_masse_sys_inge.stl
50.0 x 42.4 x 96.8
