Ingenierie-Systeme/united-team-repo/Simulateur Unity/IngeSys/IngeSys/Assets/CAD/Piscine/Piscine.obj

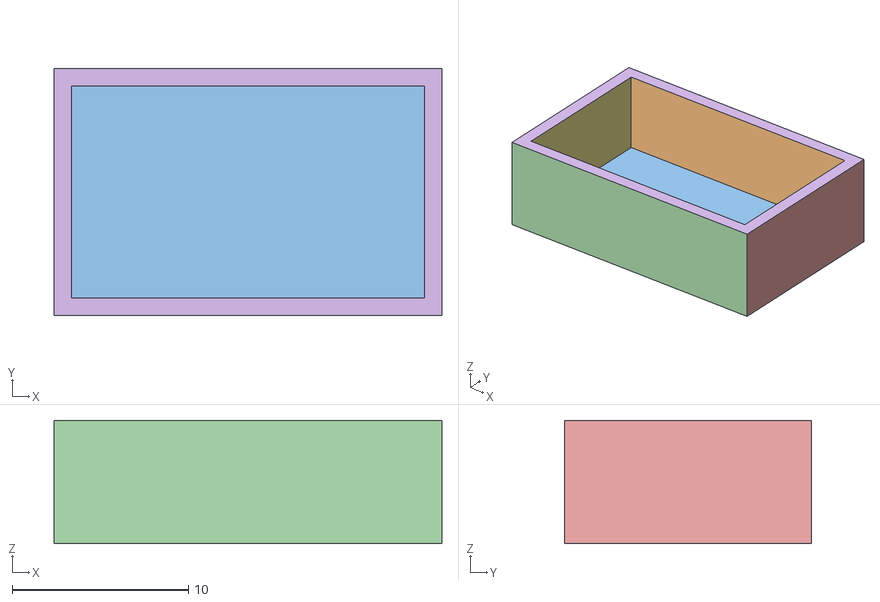
[picture p55: CAD file, 2026-10-28]
Simulateur Unity/IngeSys/IngeSys/Assets/CAD/Piscine/Piscine.obj
22.0 x 14.0 x 7.00
