Ingenierie-Systeme/united-team-repo/Simulateur Unity/IngeSys/IngeSys/Assets/CAD/Robot/CAO/Pale/pale.stl

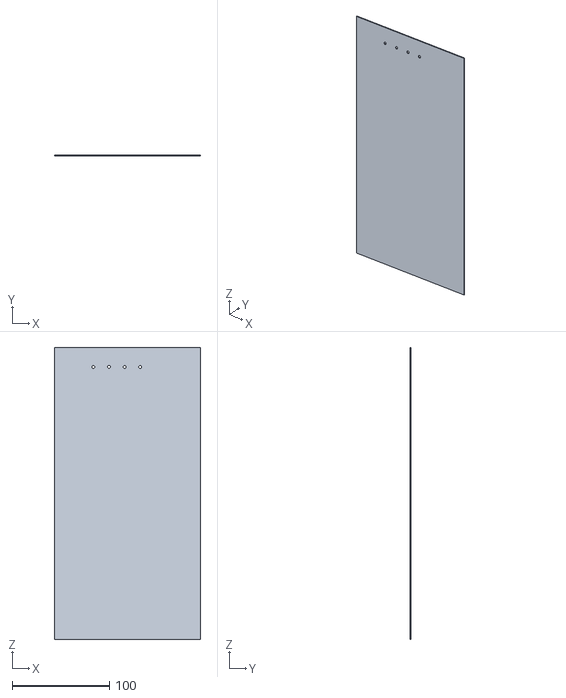
[picture p56: CAD file, 2026-11-02]
Simulateur Unity/IngeSys/IngeSys/Assets/CAD/Robot/CAO/Pale/pale.stl
150.0 x 1.00 x 300.0
