Ingenierie-Systeme/united-team-repo/Simulateur Unity/IngeSys/IngeSys/Assets/CAD/Robot/Derived/support_pale_V2.obj

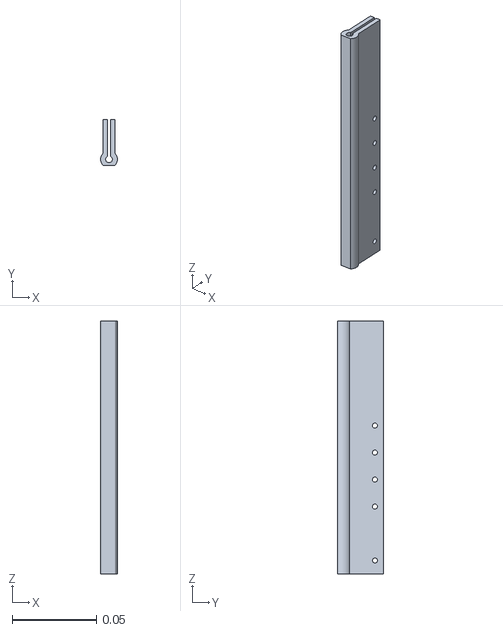
[picture p57: CAD file, 2026-11-02]
Simulateur Unity/IngeSys/IngeSys/Assets/CAD/Robot/Derived/support_pale_V2.obj
0.00999 x 0.0271 x 0.15
