Ingenierie-Systeme/united-team-repo/Simulateur Unity/IngeSys/IngeSys/Assets/CAD/Robot/CAO/Pale/lien_servo_pale_V3.stl

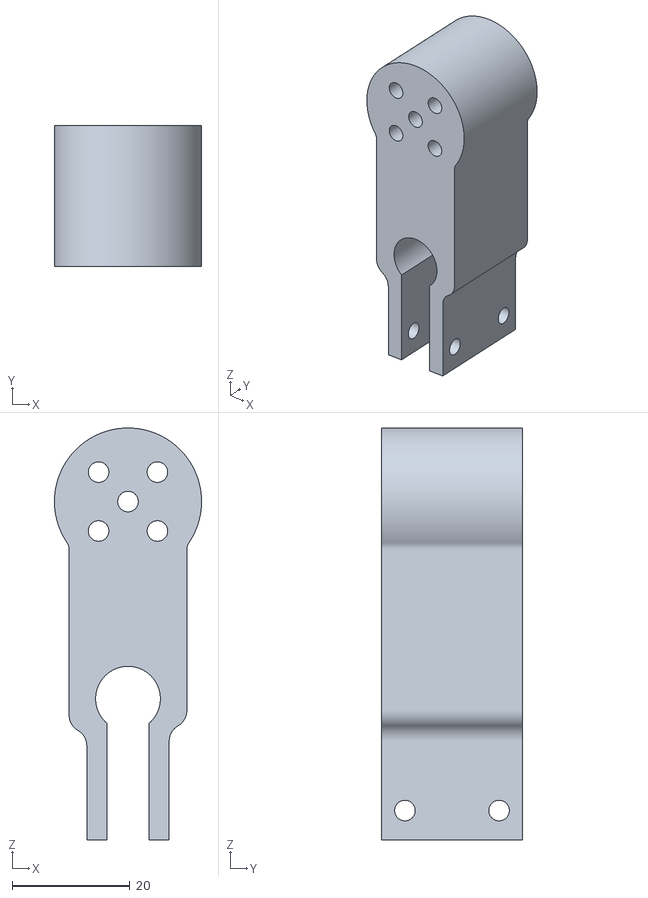
[picture p58: CAD file, 2026-10-28]
Simulateur Unity/IngeSys/IngeSys/Assets/CAD/Robot/CAO/Pale/lien_servo_pale_V3.stl
25.0 x 24.0 x 70.0
