Ingenierie-Systeme/united-team-repo/Simulateur Unity/IngeSys/IngeSys/Assets/CAD/Robot/Derived/pale.obj

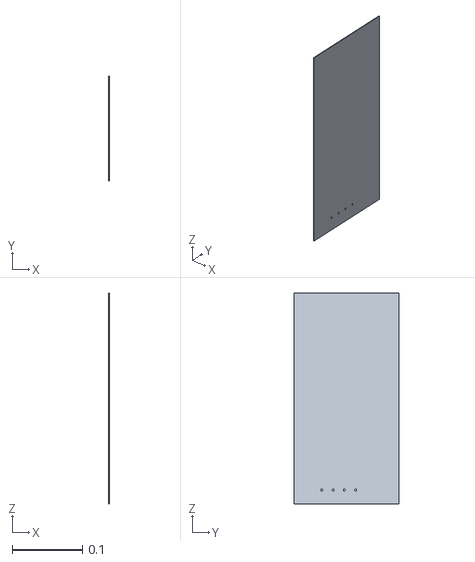
[picture p59: CAD file, 2026-11-02]
Simulateur Unity/IngeSys/IngeSys/Assets/CAD/Robot/Derived/pale.obj
0.001 x 0.15 x 0.3
