Ingenierie-Systeme/united-team-repo/Simulateur Unity/IngeSys/IngeSys/Assets/CAD/Robot/CAO/Pale/SER-0010 Titanium Servo Hub.STEP

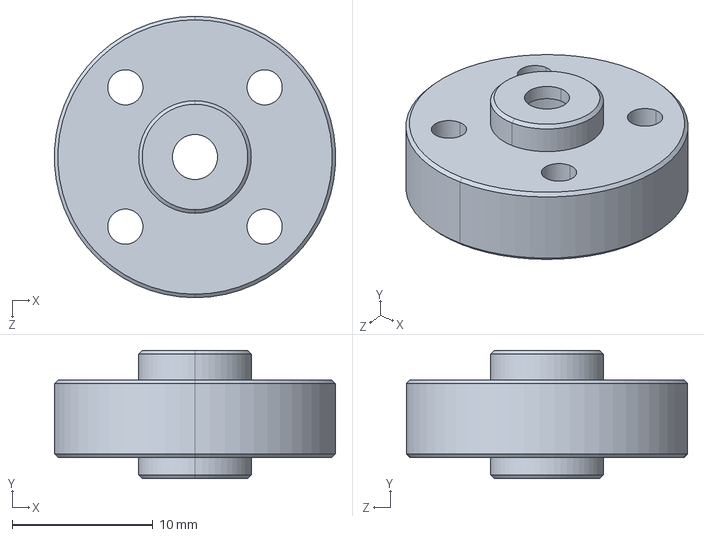
[picture p60: CAD file, 2026-10-28]
Simulateur Unity/IngeSys/IngeSys/Assets/CAD/Robot/CAO/Pale/SER-0010 Titanium Servo Hub.STEP
20.0 x 9.10 x 20.0 mm
