Ingenierie-Systeme/united-team-repo/Simulateur Unity/IngeSys/IngeSys/Assets/CAD/Robot/Derived/lien_servo_pale_V3.obj

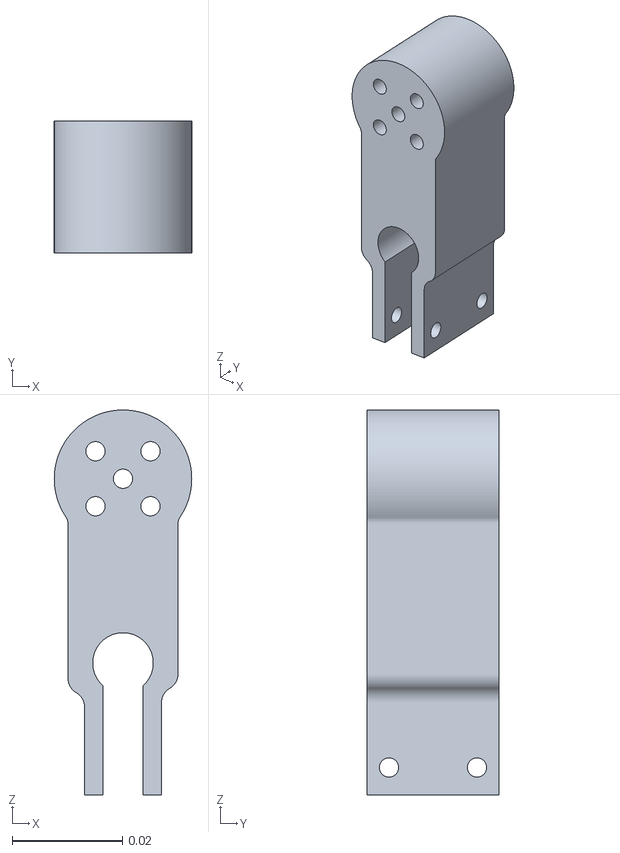
[picture p61: CAD file, 2026-11-02]
Simulateur Unity/IngeSys/IngeSys/Assets/CAD/Robot/Derived/lien_servo_pale_V3.obj
0.025 x 0.024 x 0.07
