Ingenierie-Systeme/united-team-repo/Simulateur Unity/IngeSys/IngeSys/Assets/CAD/Robot/CAO/Pale/support_pale_V2.stl

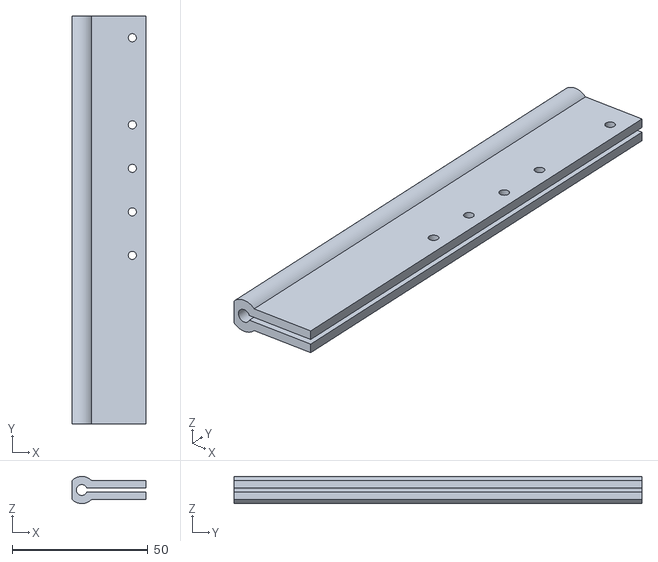
[picture p62: CAD file, 2026-10-28]
Simulateur Unity/IngeSys/IngeSys/Assets/CAD/Robot/CAO/Pale/support_pale_V2.stl
27.1 x 150.0 x 9.99
