Ingenierie-Systeme/united-team-repo/Simulateur Unity/IngeSys/IngeSys/Assets/CAD/Robot/CAO/Pale/SER-20XX Servo.STEP

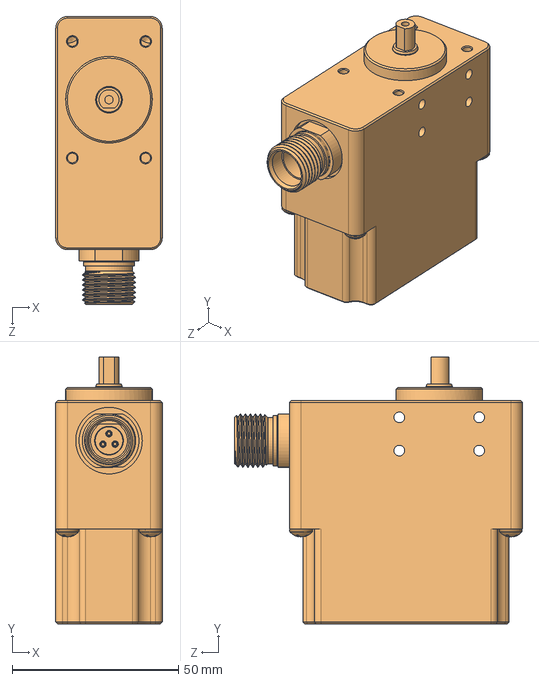
[picture p63: CAD file, 2026-10-28]
Simulateur Unity/IngeSys/IngeSys/Assets/CAD/Robot/CAO/Pale/SER-20XX Servo.STEP
32.0 x 80.1 x 86.5 mm
