Ingenierie-Systeme/united-team-repo/(list of files, cad)

Other CAD files:
Simulateur Unity/IngeSys/IngeSys/Assets/CAD/Robot/CAO/Assembly/Assembly.obj
CAO/support_masse_sys_inge.ipt
Simulateur Unity/IngeSys/IngeSys/Assets/CAD/Robot/CAO/Aileron.ipt
Simulateur Unity/IngeSys/IngeSys/Assets/CAD/Robot/CAO/Assembly/Assembly_simu.iam
Simulateur Unity/IngeSys/IngeSys/Assets/CAD/Robot/CAO/Lampe/lampe1.ipt
Simulateur Unity/IngeSys/IngeSys/Assets/CAD/Robot/CAO/Lampe/lampe2.ipt
Simulateur Unity/IngeSys/IngeSys/Assets/CAD/Robot/CAO/Lampe/lampe3.ipt
Simulateur Unity/IngeSys/IngeSys/Assets/CAD/Robot/CAO/Pale/Assemblypale.iam
Simulateur Unity/IngeSys/IngeSys/Assets/CAD/Robot/CAO/Servo/PartV4.ipt
Simulateur Unity/IngeSys/IngeSys/Assets/CAD/Robot/CAO/Servo/bras50.ipt
Simulateur Unity/IngeSys/IngeSys/Assets/CAD/Robot/CAO/support_masse_sys_inge.ipt
