Ingenierie-Systeme/united-team-repo/Simulateur Unity/IngeSys/IngeSys/Assets/Documentation/PHASE_4_RESULTS.csv

case | T_N | Y_N | x | z | speed | yawRad | yawRateRadS | servoPeakRad | servoPeakSpeedRadS | pass
off_animated | 0.000000 | 0.000000 | 0.000000 | 0.000000 | 0.000014 | 0.000000 | 0.000000 | 0.349309 | 2.193334 | True
straight | 0.490000 | 0.000000 | 0.000000 | 0.671509 | 0.263572 | 0.000000 | 0.000000 | 0.349309 | 2.193334 | True
offset_positive | 0.490000 | 0.098000 | -0.145956 | 0.610096 | 0.246710 | -1.075236 | -0.379568 | 0.549309 | 6.000000 | True
offset_negative | 0.490000 | -0.098000 | 0.145956 | 0.610096 | 0.246710 | 1.075237 | 0.379568 | 0.549309 | 6.000000 | True
cutoff | 0.000000 | 0.000000 | 0.000000 | 0.477883 | 0.096180 | 0.000000 | 0.000000 | 0.349309 | 2.193334 | True
