Ingenierie-Systeme/united-team-repo/Simulateur Unity/IngeSys/IngeSys/Assets/Documentation/PHASE_3_RESULTS.csv

case | massKg | volumeM3 | initialSubmergedM3 | finalY | finalSpeed | forwardY | s | pass
neutral | 3.891593 | 0.00389159 | 0.00389156 | 4.00005 | 0.00001 | 0.00000 | 0.0000 | True
heavy | 4.280753 | 0.00389159 | 0.00389156 | 2.30475 | 0.69467 | 0.00000 | 0.0000 | True
half | 1.945796 | 0.00389159 | 0.00194580 | 6.50000 | 0.00002 | -0.00001 | 0.0000 | True
free_decay | 3.891593 | 0.00389159 | 0.00389156 | 4.00002 | 0.21947 | 0.00000 | 0.0000 | True
mass_forward | 3.891593 | 0.00389159 | 0.00389156 | 3.95721 | 0.00002 | -0.83421 | 0.1200 | True
mass_aft | 3.891593 | 0.00389159 | 0.00389156 | 4.04564 | 0.00002 | 0.83421 | -0.1200 | True
half_tilt | 1.945796 | 0.00389159 | 0.00160078 | 6.49952 | 0.06141 | 0.01035 | 0.0000 | True
