Ingenierie-Systeme/united-team-repo/Schemas/SchémaElec.drawio.pdf

### LAMPE Blue Robotics LUMEN

### BAR30 — CAPTEUR DE PRESSION

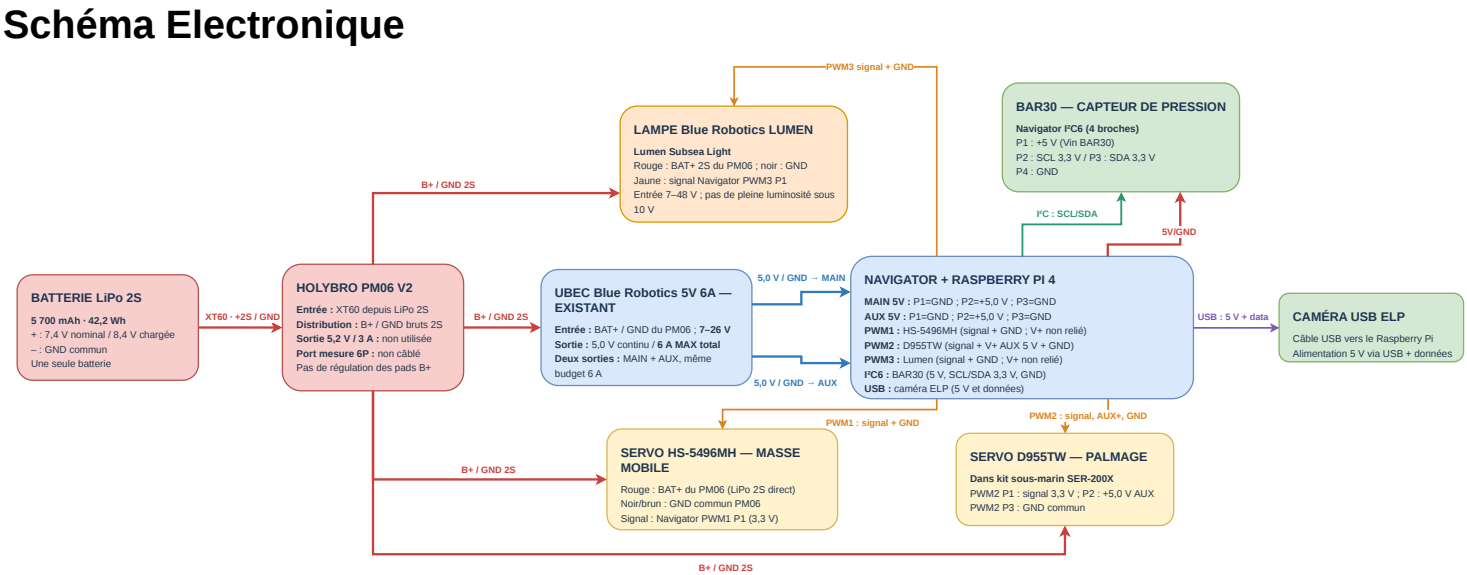
[picture p64: page 1]
BATTERIE LiPo 2S; HOLYBRO PM06 V2; SERVO D955TW — PALMAGE; Navigator I²C6 (4 broches) P1 : +5 V (Vin BAR30) P2 : SCL 3,3 V / P3 : SDA 3,3 V P4 : GND; XT60 · +2S / GND; B+ / GND 2S; 5,0 V / GND → MAIN; PWM1 : signal + GND; PWM3 signal + GND; USB : 5 V + data; 5,0 V / GND → AUX; 5V/GND; Schéma Electronique

Lumen Subsea Light
Rouge : BAT+ 2S du PM06 ; noir : GND
Jaune : signal Navigator PWM3 P1
Entrée 7–48 V ; pas de pleine luminosité sous

I²C : SCL/SDA

NAVIGATOR + RASPBERRY PI 4

UBEC Blue Robotics 5V 6A —
EXISTANT

MAIN 5V : P1=GND ; P2=+5,0 V ; P3=GND
AUX 5V : P1=GND ; P2=+5,0 V ; P3=GND
PWM1 : HS-5496MH (signal + GND ; V+ non relié)
PWM2 : D955TW (signal + V+ AUX 5 V + GND)
PWM3 : Lumen (signal + GND ; V+ non relié)
I²C6 : BAR30 (5 V, SCL/SDA 3,3 V, GND)
USB : caméra ELP (5 V et données)

Entrée : XT60 depuis LiPo 2S
Distribution : B+ / GND bruts 2S
Sortie 5,2 V / 3 A : non utilisée
Port mesure 6P : non câblé
Pas de régulation des pads B+

CAMÉRA USB ELP

5 700 mAh · 42,2 Wh
+ : 7,4 V nominal / 8,4 V chargée
– : GND commun
Une seule batterie

Entrée : BAT+ / GND du PM06 ; 7–26 V
Sortie : 5,0 V continu / 6 A MAX total
Deux sorties : MAIN + AUX, même
budget 6 A

Câble USB vers le Raspberry Pi
Alimentation 5 V via USB + données

PWM2 : signal, AUX+, GND

SERVO HS-5496MH — MASSE
MOBILE

Dans kit sous-marin SER-200X
PWM2 P1 : signal 3,3 V ; P2 : +5,0 V AUX
PWM2 P3 : GND commun

Rouge : BAT+ du PM06 (LiPo 2S direct)
Noir/brun : GND commun PM06
Signal : Navigator PWM1 P1 (3,3 V)
