Ingenierie-Systeme/united-team-repo/(commit log)

2026-10-28 Added Simulator
    [PHASE_3_RESULTS.csv, PHASE_4_RESULTS.csv, Piscine.obj]
2026-10-28 Added Karstic Lamp and Camera View
2026-10-28 Added ROS2 TCP ENDPOINT and IMU sensor in Simulation
2026-10-28 Added barometer and depth sensor
2026-10-28 Ajout des CAO : support masse / servo / lampe_p_V1
    [Aileron.ipt, Assembly.obj, PartV4.ipt, bras50.ipt, lampe1.ipt, lampe2.ipt, lampe3.ipt, support_masse_sys_inge.ipt]
2026-10-28 CAO Pale
    [Assemblypale.iam, SER-0010 Titanium Servo Hub.STEP, SER-20XX Servo.STEP, lien_servo_pale_V3.stl, support_pale_V2.stl]
2026-10-29 add assemblage simu
    [Assembly_simu.iam]
2026-11-02 Added Assembly to simulation
    [Aileron.ipt, Assembly.obj, Assembly_simu.iam, Assemblypale.iam, PartV4.ipt, SER-0010 Titanium Servo Hub.STEP, SER-20XX Servo.STEP, bras50.ipt]
2026-11-02 Update README with Bill of Materials link
    Added a link to the Bill of Materials and Budget in the README.
2026-11-04 Ajout CAO support Masse
    [support_masse_sys_inge.ipt, support_masse_sys_inge.stl]
